ExcessiveOverkill/hvsd-3ch/KiCad/RJ45-Pinout-T568B.jpg

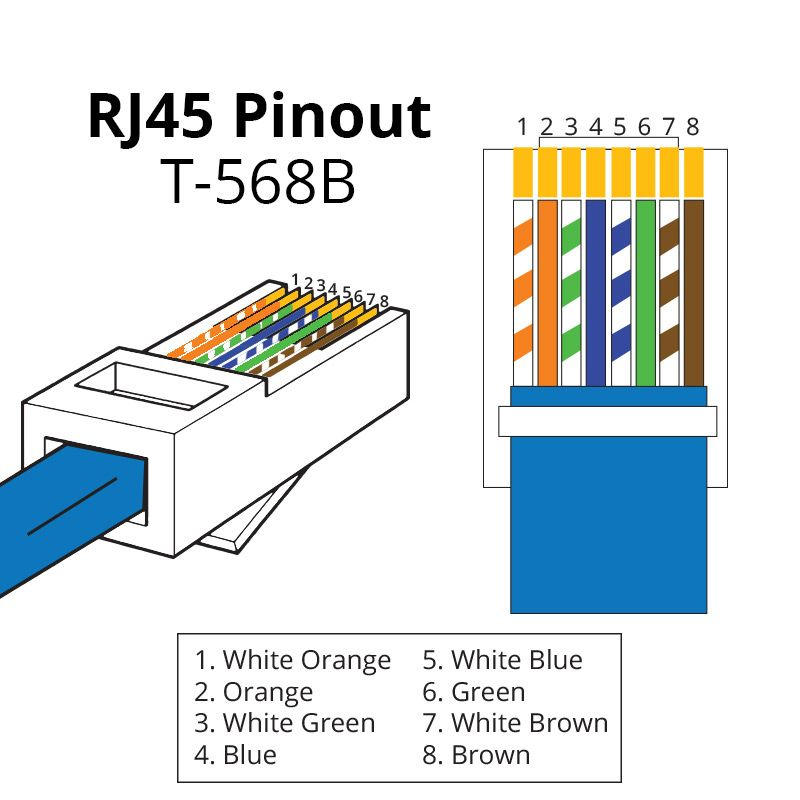
KiCad/RJ45-Pinout-T568B.jpg
