ExcessiveOverkill/hvsd-3ch/KiCad/3d/STM32G473QET6.step

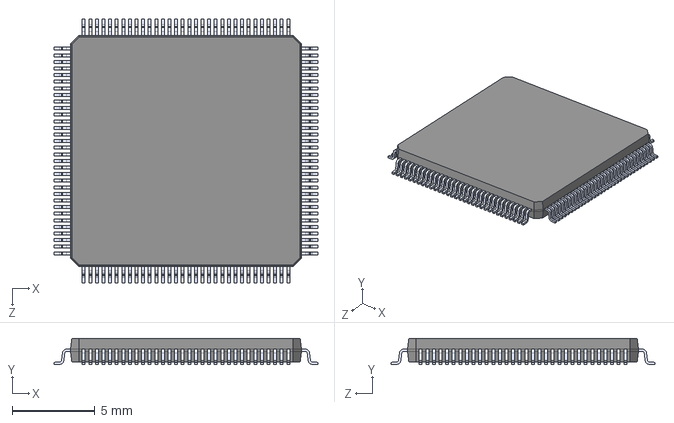
[picture p2: CAD file, 2026-01-03]
KiCad/3d/STM32G473QET6.step
16.0 x 1.60 x 16.0 mm
