ExcessiveOverkill/hvsd-3ch/LTspice/dc vus caps.asc

C1: cap; 220µf; Rser=480m Lser=20nH
C2: cap; 50µf; Rser=4.2m Lser=37.5nH
C3: cap; .3µf
C4: cap; 50µf; Rser=4.2m Lser=37.5nH
C5: cap; 50µf; Rser=4.2m Lser=37.5nH
C6: cap; 1000nf; Lser=15nH
I1: current; PULSE(40 0 0 150ns 150ns 33us 66us 100)
I2: current; PULSE(0 0 22us 150ns 150ns 33us 66us 100)
I3: current; PULSE(0 0 44us 150ns 150ns 33us 66us 100)
L1: ind; 180nH; Rser=.002
L2: ind; 440nH; Rser=.002
V1: voltage; 350; Rser=.1
Named nets: 0
.tran 0 .005 0
