ExcessiveOverkill/hvsd-3ch/KiCad/high voltage servo drive 3ch/high voltage servo drive 3ch.kicad_pcb

## KiCad design KiCad/high voltage servo drive 3ch/high voltage servo drive 3ch.kicad_pcb (2026-08-24)

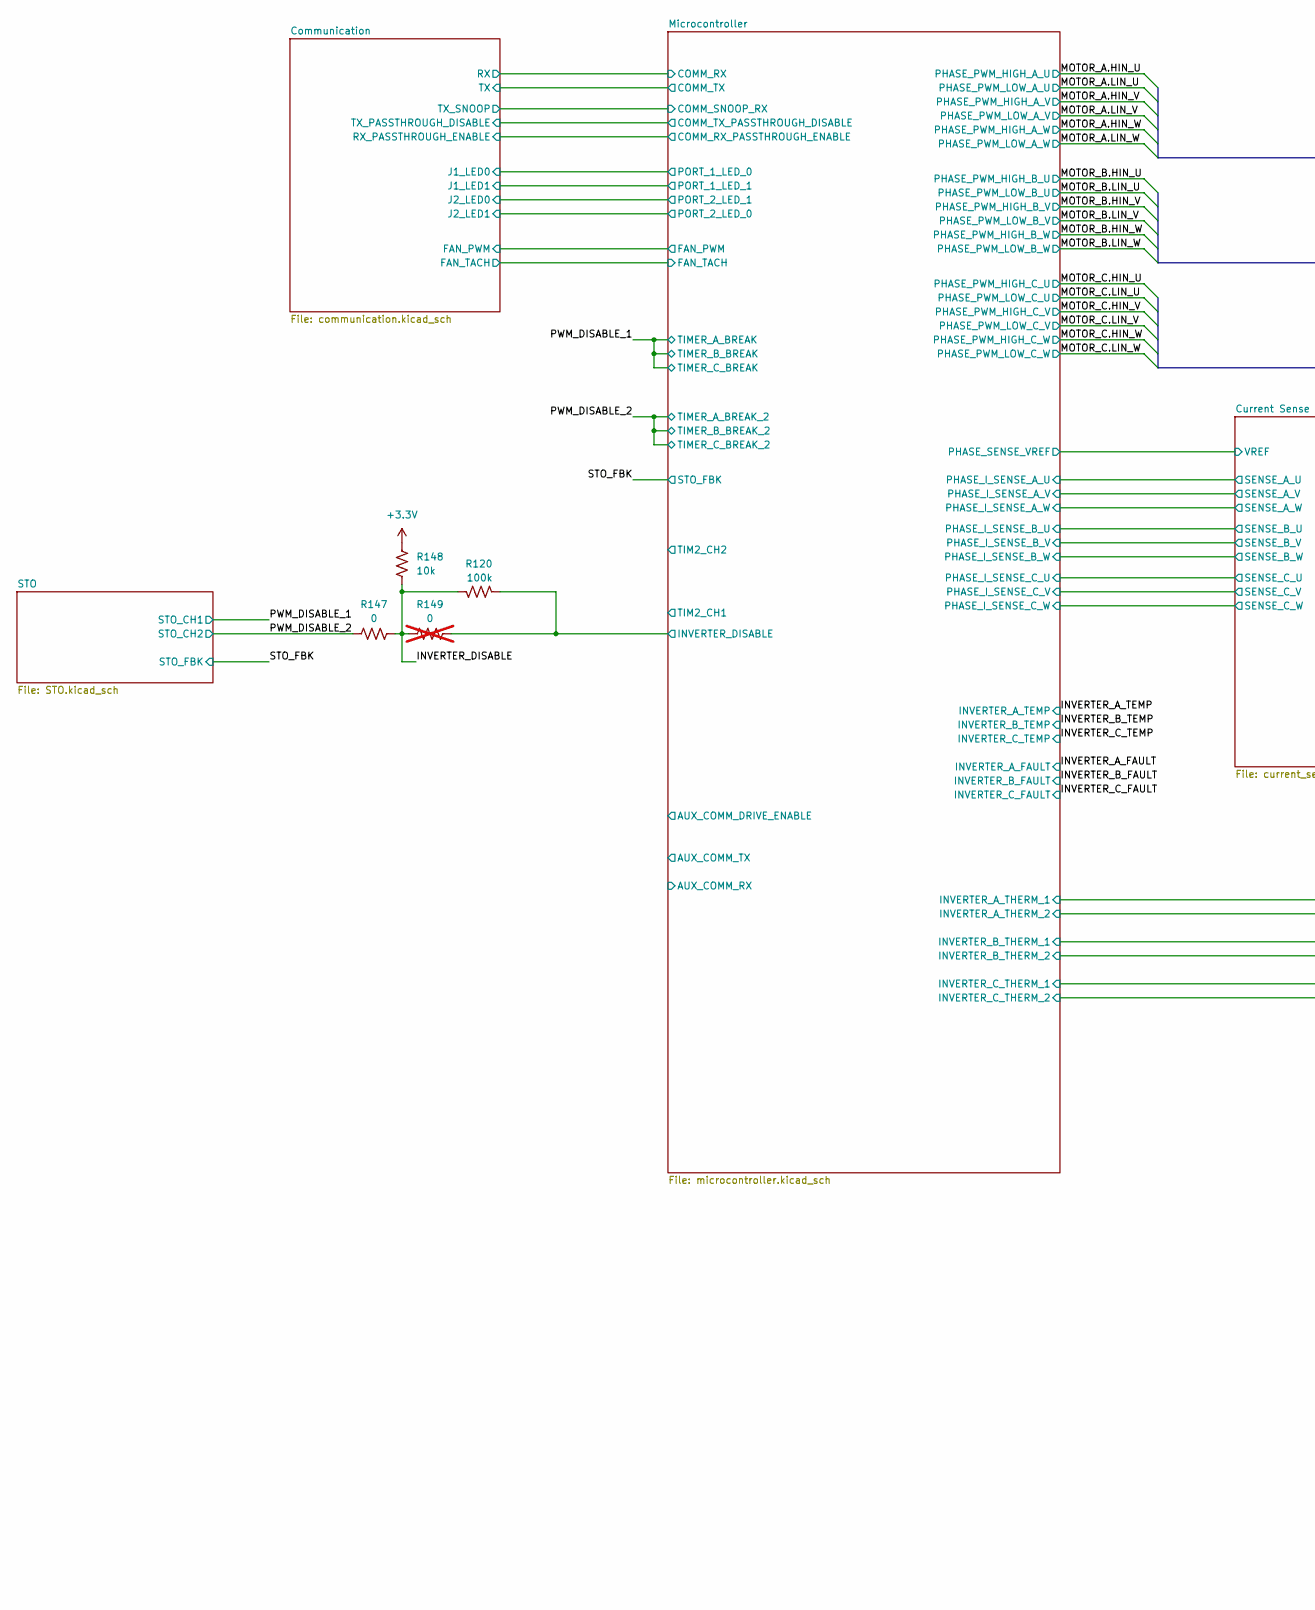
[picture p3: schematic high voltage servo drive 3ch.kicad_sch, part in row 1, column 1]

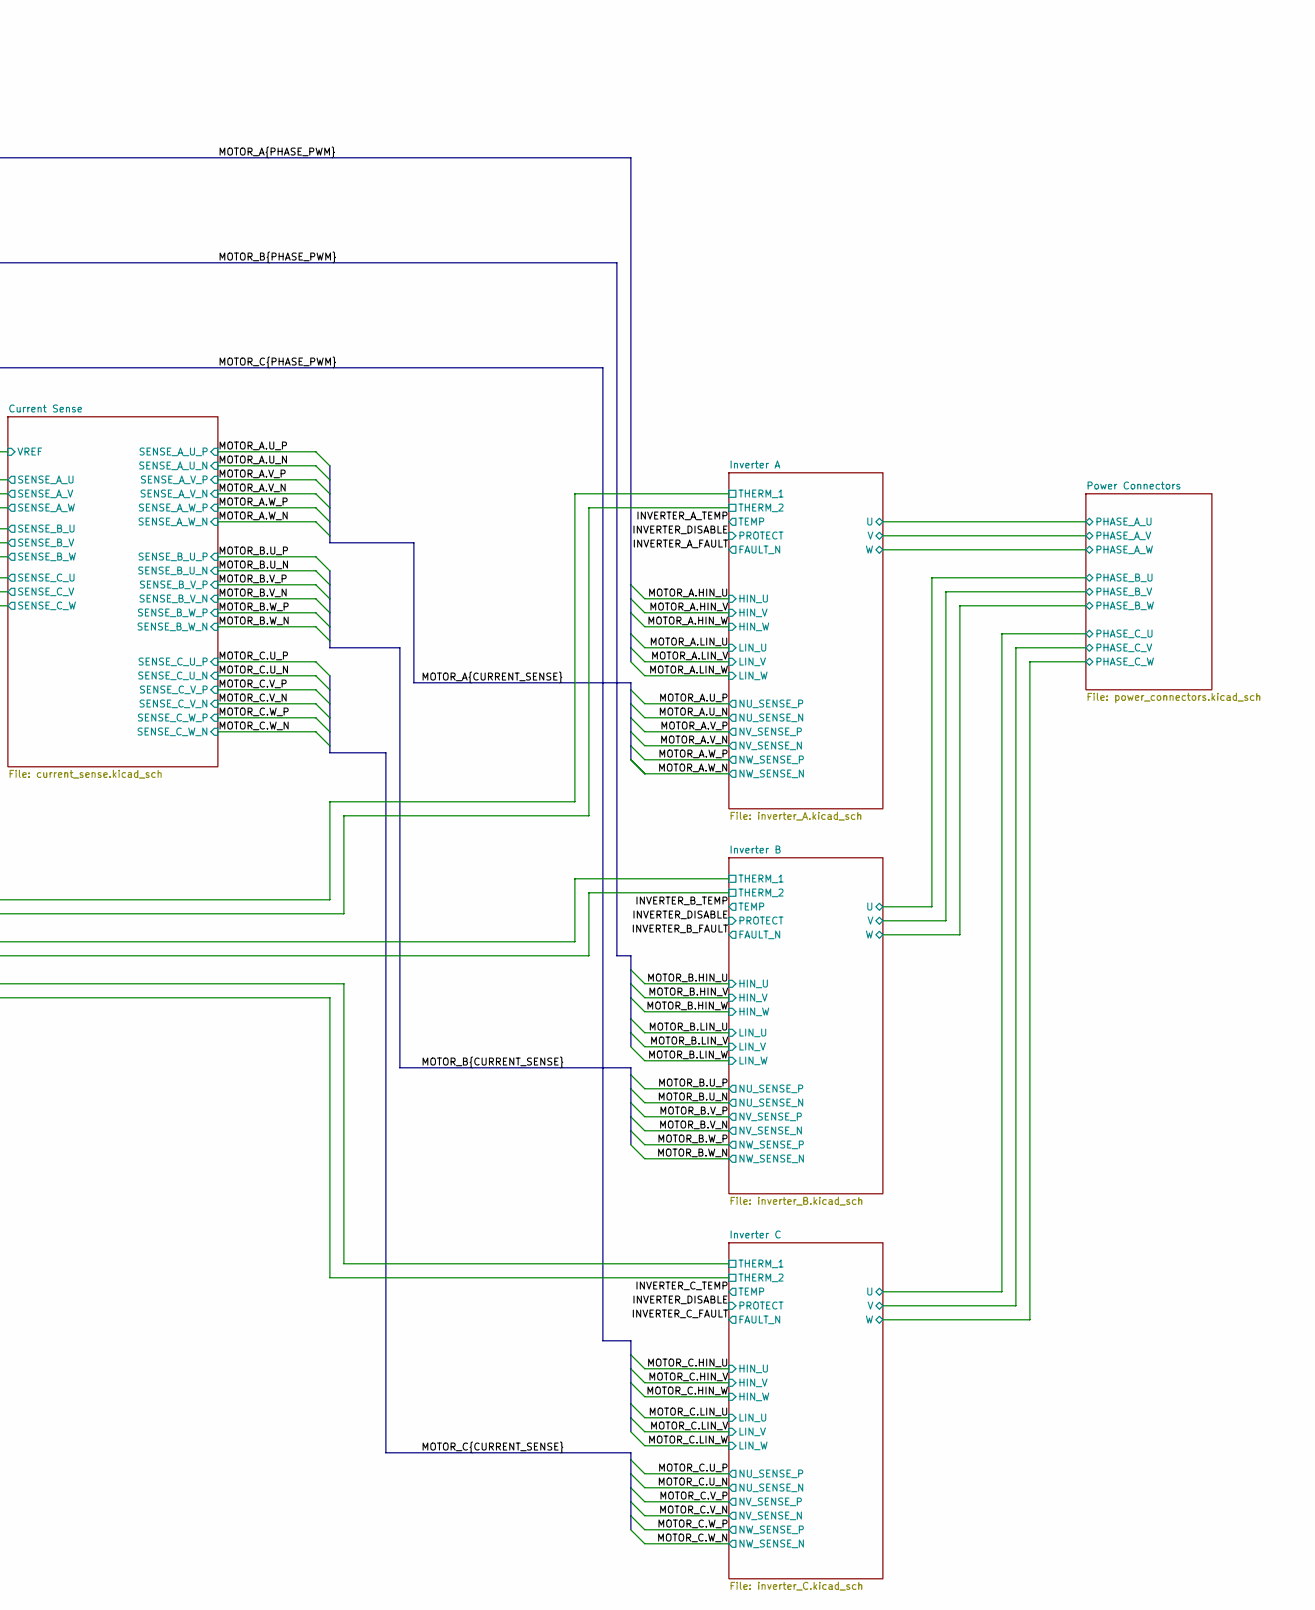
[picture p4: schematic high voltage servo drive 3ch.kicad_sch, part in row 1, column 2]

Parts:
R120: 100k; R_0402_1005Metric; Part number RC0402FR-07100KL; LCSC# C60491
R147: 0; R_0402_1005Metric; Part number RC0402FR-070RL; LCSC# C106231
R148: 10k; R_0402_1005Metric; Part number RC0402FR-0710KL; LCSC# C60490
R149: 0; R_0402_1005Metric; Part number RC0402FR-070RL; LCSC# C106231; not fitted

Connections:
+3.3V: R148.2; also elsewhere on the board
/INVERTER_DISABLE: R120.2, R147.2, R148.1, R149.1; also elsewhere on the board
/Microcontroller/INVERTER_DISABLE: R120.1, R149.2; also elsewhere on the board
/PWM_DISABLE_2: R147.1; also elsewhere on the board

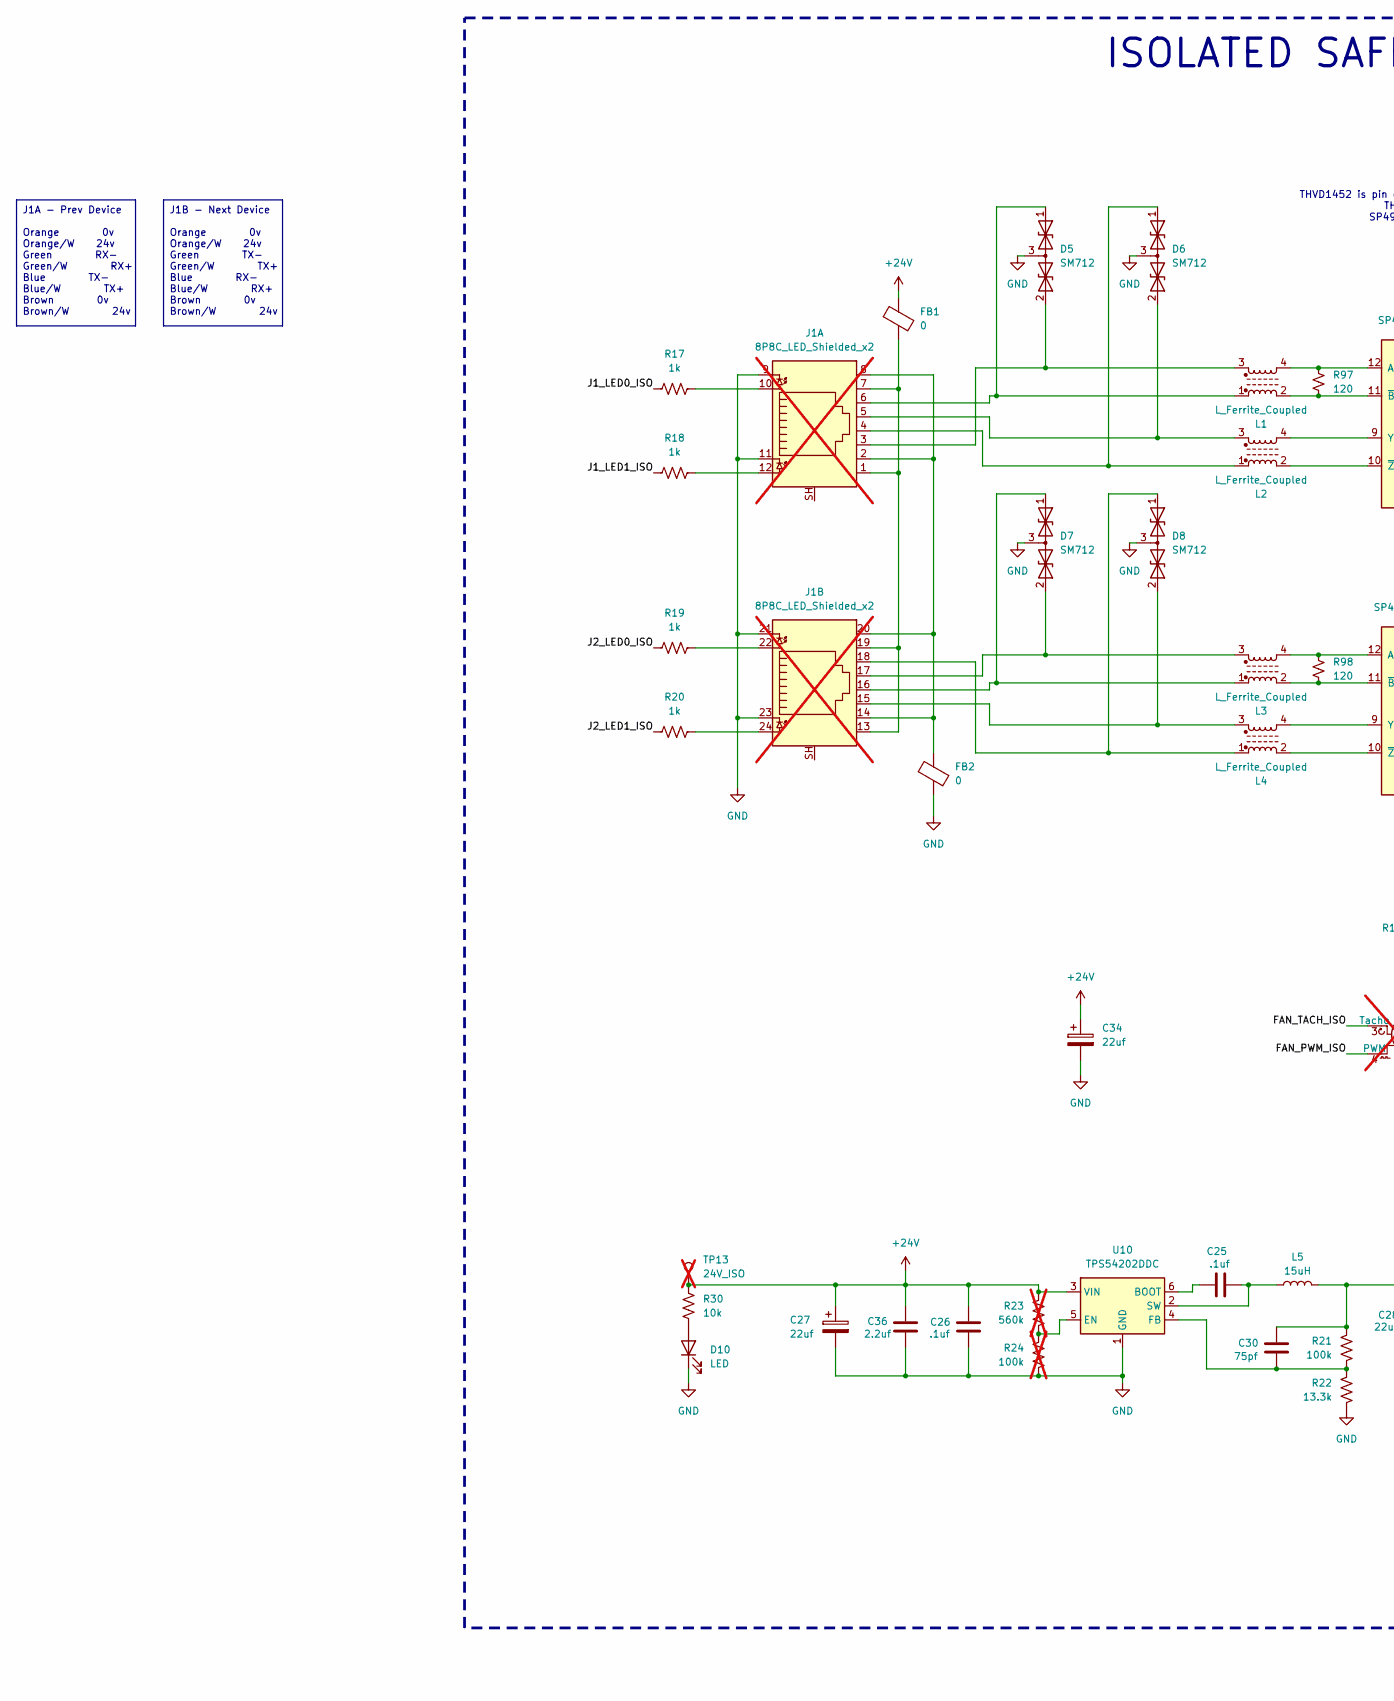
[picture p5: schematic communication.kicad_sch, part in row 1, column 1]

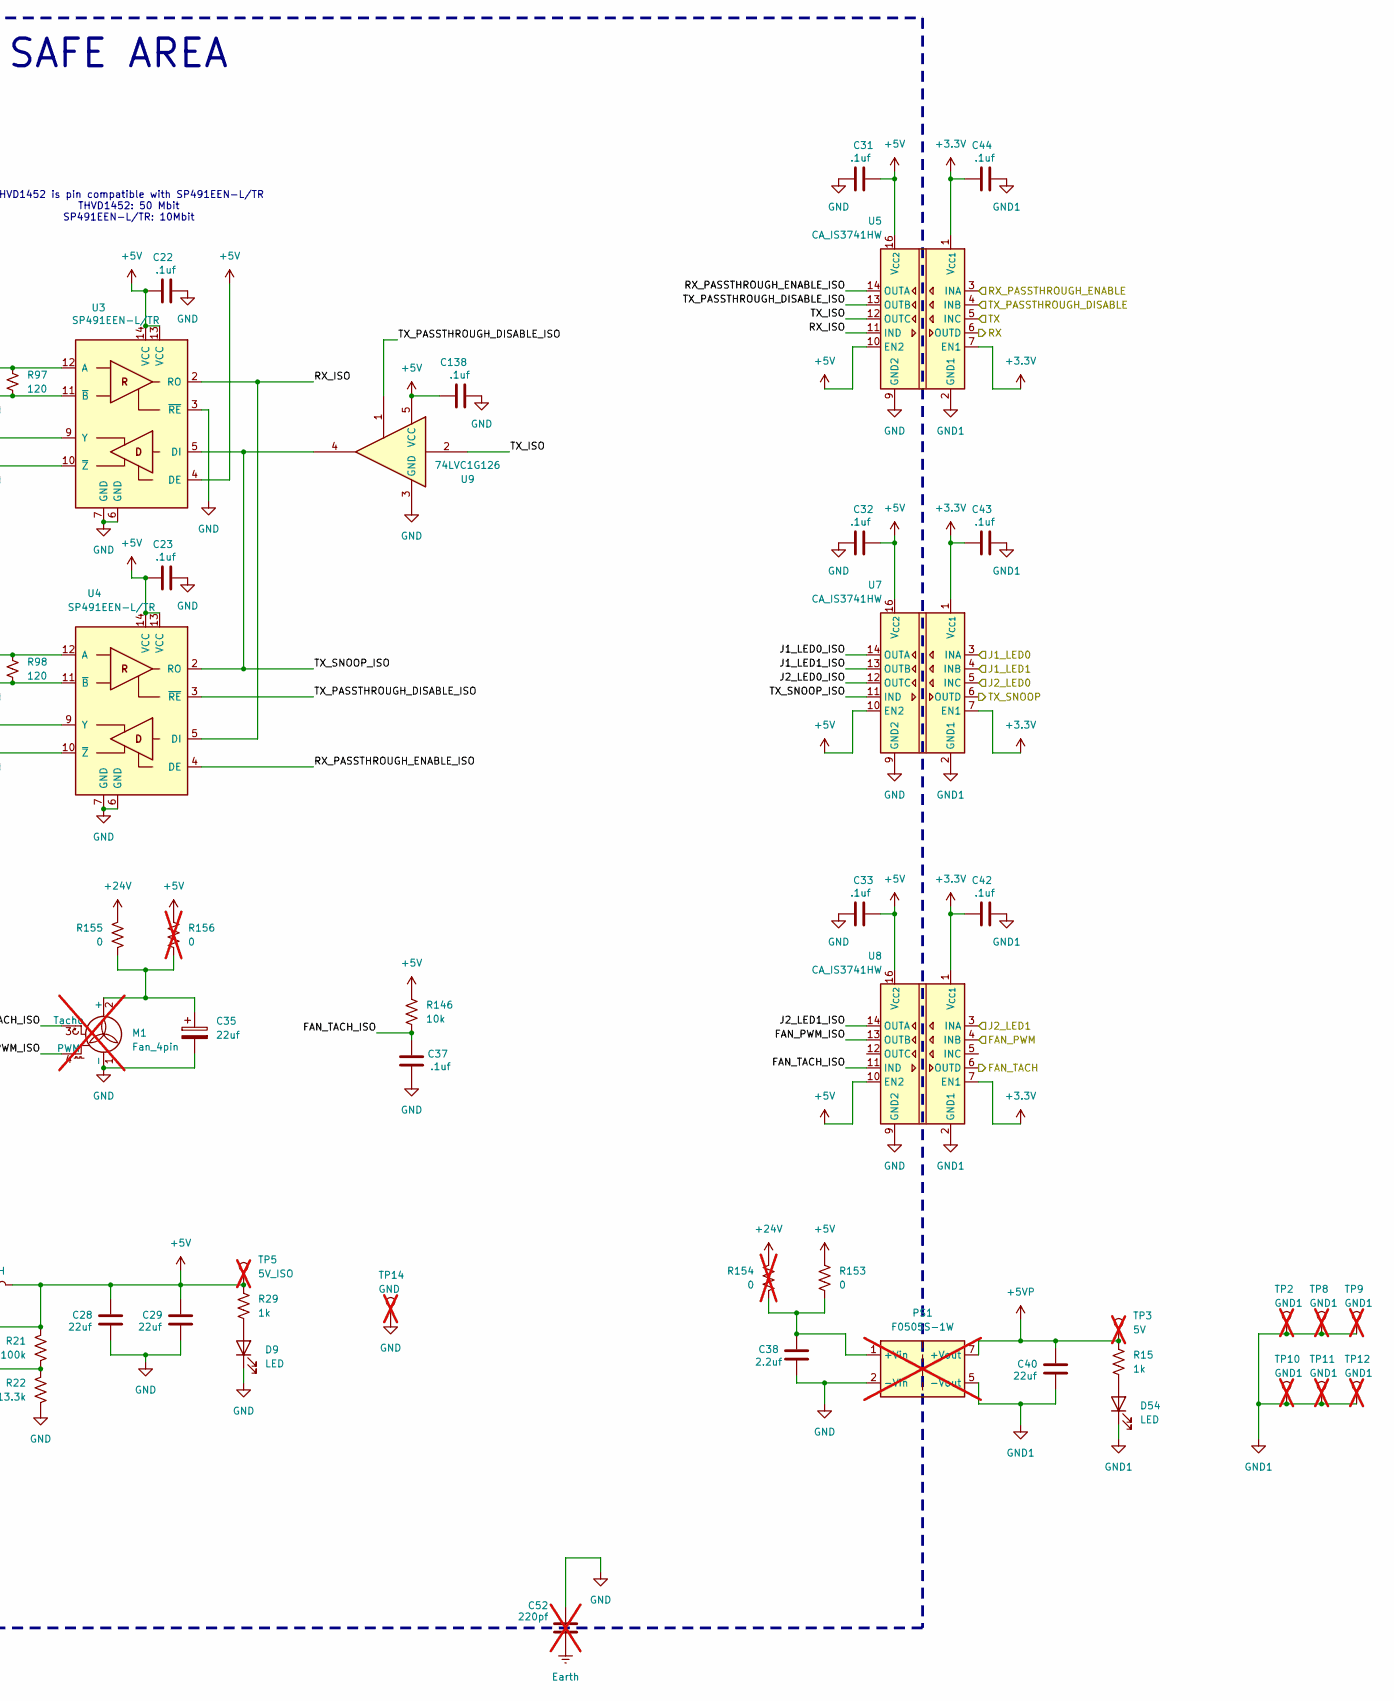
[picture p6: schematic communication.kicad_sch, part in row 1, column 2]

Parts:
C22, C23, C25, C26, C31, C32, C33, C37, C42, C43, C44, C138: .1uf; C_0402_1005Metric; Part number CC0402KRX5R9BB104; LCSC# C105882
C27, C34, C35: 22uf; CP_Elec_6.3x5.9; Part number 189RV0014; LCSC# C7471876
C28, C29, C40: 22uf; C_1206_3216Metric; Part number CL31A226KAHNNNE; LCSC# C12891
C30: 75pf; C_0402_1005Metric; Part number CC0402JRNPO9BN750; LCSC# C107010
C36, C38: 2.2uf; C_1206_3216Metric; Part number CL31B225KBHNNNE; LCSC# C50254
C52: 220pf; C_Disc_D9.0mm_W5.0mm_P10.00mm; not fitted
D5, D6, D7, D8: SM712; SOT-23; Part number CDSOT23-SM712-ES; LCSC# C5199207
D9, D10, D54: LED; LED_0603_1608Metric; Part number XL-1608UGC-04; LCSC# C965804
FB1, FB2: 0; L_0805_2012Metric; Part number FRC0805P000 TS; LCSC# C2907288
J1: 8P8C_LED_Shielded_x2; RJ45_XDRJ-1609-002; Part number XDRJ-1609-002; LCSC# C7498193; not fitted
L1, L2, L3, L4: L_Ferrite_Coupled; SMD-4P,2x1.2mm; Part number CND-WCM0805M801-2; LCSC# C3020807
L5: 15uH; CY54_INDUCTOR; Part number CY54-15UH; LCSC# C2929432
M1: Fan_4pin; PinHeader_1x04_P2.54mm_Vertical; not fitted
PS1: F0505S-1W; Converter_DCDC_FXXS-1W; Part number F0505S-1WR3; LCSC# C2992398; not fitted
R15, R17, R18, R19, R20, R29: 1k; R_0402_1005Metric; Part number RC0402FR-071KL; LCSC# C106235
R21: 100k; R_0402_1005Metric; Part number RC0402FR-07100KL; LCSC# C60491
R22: 13.3k; R_0402_1005Metric; Part number RC0402FR-0713K3L; LCSC# C274352
R23: 560k; R_0402_1005Metric; Part number RC0402FR-07560KL; LCSC# C137958; not fitted
R24: 100k; R_0402_1005Metric; Part number RC0402FR-07100KL; LCSC# C60491; not fitted
R30, R146: 10k; R_0402_1005Metric; Part number RC0402FR-0710KL; LCSC# C60490
R97, R98: 120; R_0402_1005Metric; Part number RC0402FR-07120RL; LCSC# C114758
R153, R155: 0; R_0402_1005Metric; Part number RC0402FR-070RL; LCSC# C106231
R154, R156: 0; R_0402_1005Metric; Part number RC0402FR-070RL; LCSC# C106231; not fitted
TP2, TP8, TP9, TP10, TP11, TP12: GND1; TestPoint_THTPad_D2.0mm_Drill1.0mm; not fitted
TP3: 5V; TestPoint_Pad_D2.0mm; not fitted
TP5: 5V_ISO; TestPoint_Pad_D2.0mm; not fitted
TP13: 24V_ISO; TestPoint_Pad_D2.0mm; not fitted
TP14: GND; TestPoint_THTPad_D2.0mm_Drill1.0mm; not fitted
U3, U4: SP491EEN-L/TR; SOIC-14_3.9x8.7mm_P1.27mm; Part number SP491EEN-L/TR; LCSC# C32476
U5, U7, U8: CA_IS3741HW; SOIC-16W_7.5x10.3mm_P1.27mm; Part number CA-IS3741HW; LCSC# C428890
U9: 74LVC1G126; SOT-353_SC-70-5; Part number 74LVC1G126CT05ARCQ; LCSC# C48391411
U10: TPS54202DDC; SOT-23-6; Part number TPS54202DDCR; LCSC# C191884

Connections:
+3.3V: C42.1, C43.1, C44.1, U5.1 (V_{CC1}), U5.7 (EN1), U7.1 (V_{CC1}), U7.7 (EN1), U8.1 (V_{CC1}), U8.7 (EN1); also elsewhere on the board
+5V: C22.1, C23.1, C28.2, C29.2, C30.2, C31.1, C32.1, C33.1, C138.1, L5.2, R21.2, R29.2, R146.2, R153.2, R156.2, TP5.1, U3.4 (DE), U3.13 (VCC), U3.14 (VCC), U4.13 (VCC), U4.14 (VCC), U5.10 (EN2), U5.16 (V_{CC2}), U7.10 (EN2), U7.16 (V_{CC2}), U8.10 (EN2), U8.16 (V_{CC2}), U9.5 (VCC)
+5VP: C40.2, PS1.7 (+Vout), R15.2, TP3.1; also elsewhere on the board
+24V: C26.2, C27.1, C34.1, C36.2, FB1.1, R23.2, R30.2, R154.2, R155.2, TP13.1, U10.3 (VIN)
/Communication/FAN_PWM: U8.4 (INB); also elsewhere on the board
/Communication/FAN_PWM_ISO: M1.4 (PWM), U8.13 (OUTB)
/Communication/FAN_TACH: U8.6 (OUTD); also elsewhere on the board
/Communication/FAN_TACH_ISO: C37.1, M1.3 (Tacho), R146.1, U8.11 (IND)
/Communication/J1_LED0: U7.3 (INA); also elsewhere on the board
/Communication/J1_LED0_ISO: R17.1, U7.14 (OUTA)
/Communication/J1_LED1: U7.4 (INB); also elsewhere on the board
/Communication/J1_LED1_ISO: R18.1, U7.13 (OUTB)
/Communication/J2_LED0: U7.5 (INC); also elsewhere on the board
/Communication/J2_LED0_ISO: R19.1, U7.12 (OUTC)
/Communication/J2_LED1: U8.3 (INA); also elsewhere on the board
/Communication/J2_LED1_ISO: R20.1, U8.14 (OUTA)
/Communication/RX_ISO: U3.2 (RO), U4.5 (DI), U5.11 (IND)
/Communication/RX_PASSTHROUGH_ENABLE: U5.3 (INA); also elsewhere on the board
/Communication/RX_PASSTHROUGH_ENABLE_ISO: U4.4 (DE), U5.14 (OUTA)
/Communication/TX: U5.5 (INC); also elsewhere on the board
/Communication/TX_ISO: U5.12 (OUTC), U9.2
/Communication/TX_PASSTHROUGH_DISABLE: U5.4 (INB); also elsewhere on the board
/Communication/TX_PASSTHROUGH_DISABLE_ISO: U4.3 (~RE), U5.13 (OUTB), U9.1
/Communication/TX_SNOOP: U7.6 (OUTD); also elsewhere on the board
/Communication/TX_SNOOP_ISO: U3.5 (DI), U4.2 (RO), U7.11 (IND), U9.4
/Microcontroller/COMM_RX: U5.6 (OUTD); also elsewhere on the board
GND: C22.2, C23.2, C26.1, C27.2, C28.1, C29.1, C31.2, C32.2, C33.2, C34.2, C35.2, C36.1, C37.2, C38.1, C52.2, C138.2, D5.3 (common), D6.3 (common), D7.3 (common), D8.3 (common), D9.1 (K), D10.1 (K), FB2.2, J1.9, J1.11, J1.21, J1.23, M1.1 (-), PS1.2 (-Vin), R22.1, R24.1, TP14.1, U3.3 (~RE), U3.6 (GND), U3.7 (GND), U4.6 (GND), U4.7 (GND), U5.9 (GND2), U5.15 (GND2), U7.9 (GND2), U7.15 (GND2), U8.9 (GND2), U8.15 (GND2), U9.3 (GND), U10.1 (GND)
unnamed: D5.1 (A1), J1.6, L1.1
unnamed: D5.2 (A2), J1.3, L1.3
unnamed: D6.1 (A1), J1.4, L2.1
unnamed: D6.2 (A2), J1.5, L2.3
unnamed: D7.1 (A1), J1.16, L3.1
unnamed: D7.2 (A2), J1.17, L3.3
unnamed: D8.1 (A1), J1.18, L4.1
unnamed: D8.2 (A2), J1.15, L4.3
unnamed: D9.2 (A), R29.1
unnamed: D10.2 (A), R30.1
unnamed: D54.2 (A), R15.1
unnamed: FB1.2, J1.1, J1.7, J1.13, J1.19
unnamed: FB2.1, J1.2, J1.8, J1.14, J1.20
unnamed: J1.10, R17.2
unnamed: J1.12, R18.2
unnamed: J1.22, R19.2
unnamed: J1.24, R20.2
unnamed: C35.1, M1.2 (+), R155.1, R156.1
unnamed: C38.2, PS1.1 (+Vin), R153.1, R154.1
unnamed: L1.4, R97.1, U3.12 (A)
unnamed: L2.4, U3.9 (Y)
unnamed: L1.2, R97.2, U3.11 (~B)
unnamed: L2.2, U3.10 (~Z)
unnamed: L3.4, R98.1, U4.12 (A)
unnamed: L4.4, U4.9 (Y)
unnamed: L3.2, R98.2, U4.11 (~B)
unnamed: L4.2, U4.10 (~Z)
unnamed: C25.1, U10.6 (BOOT)
unnamed: R23.1, R24.2, U10.5 (EN)
unnamed: C30.1, R21.1, R22.2, U10.4 (FB)
unnamed: C25.2, L5.1, U10.2 (SW)

Notes on the sheet:
J1B - Next Device Orange 0v Orange/W 24v Green TX- Green/W TX+ Blue RX- Blue/W RX+ Brown 0v Brown/W 24v
J1A - Prev Device Orange 0v Orange/W 24v Green RX- Green/W RX+ Blue TX- Blue/W TX+ Brown 0v Brown/W 24v
THVD1452 is pin compatible with SP491EEN-L/TR THVD1452: 50 Mbit SP491EEN-L/TR: 10Mbit
ISOLATED SAFE AREA

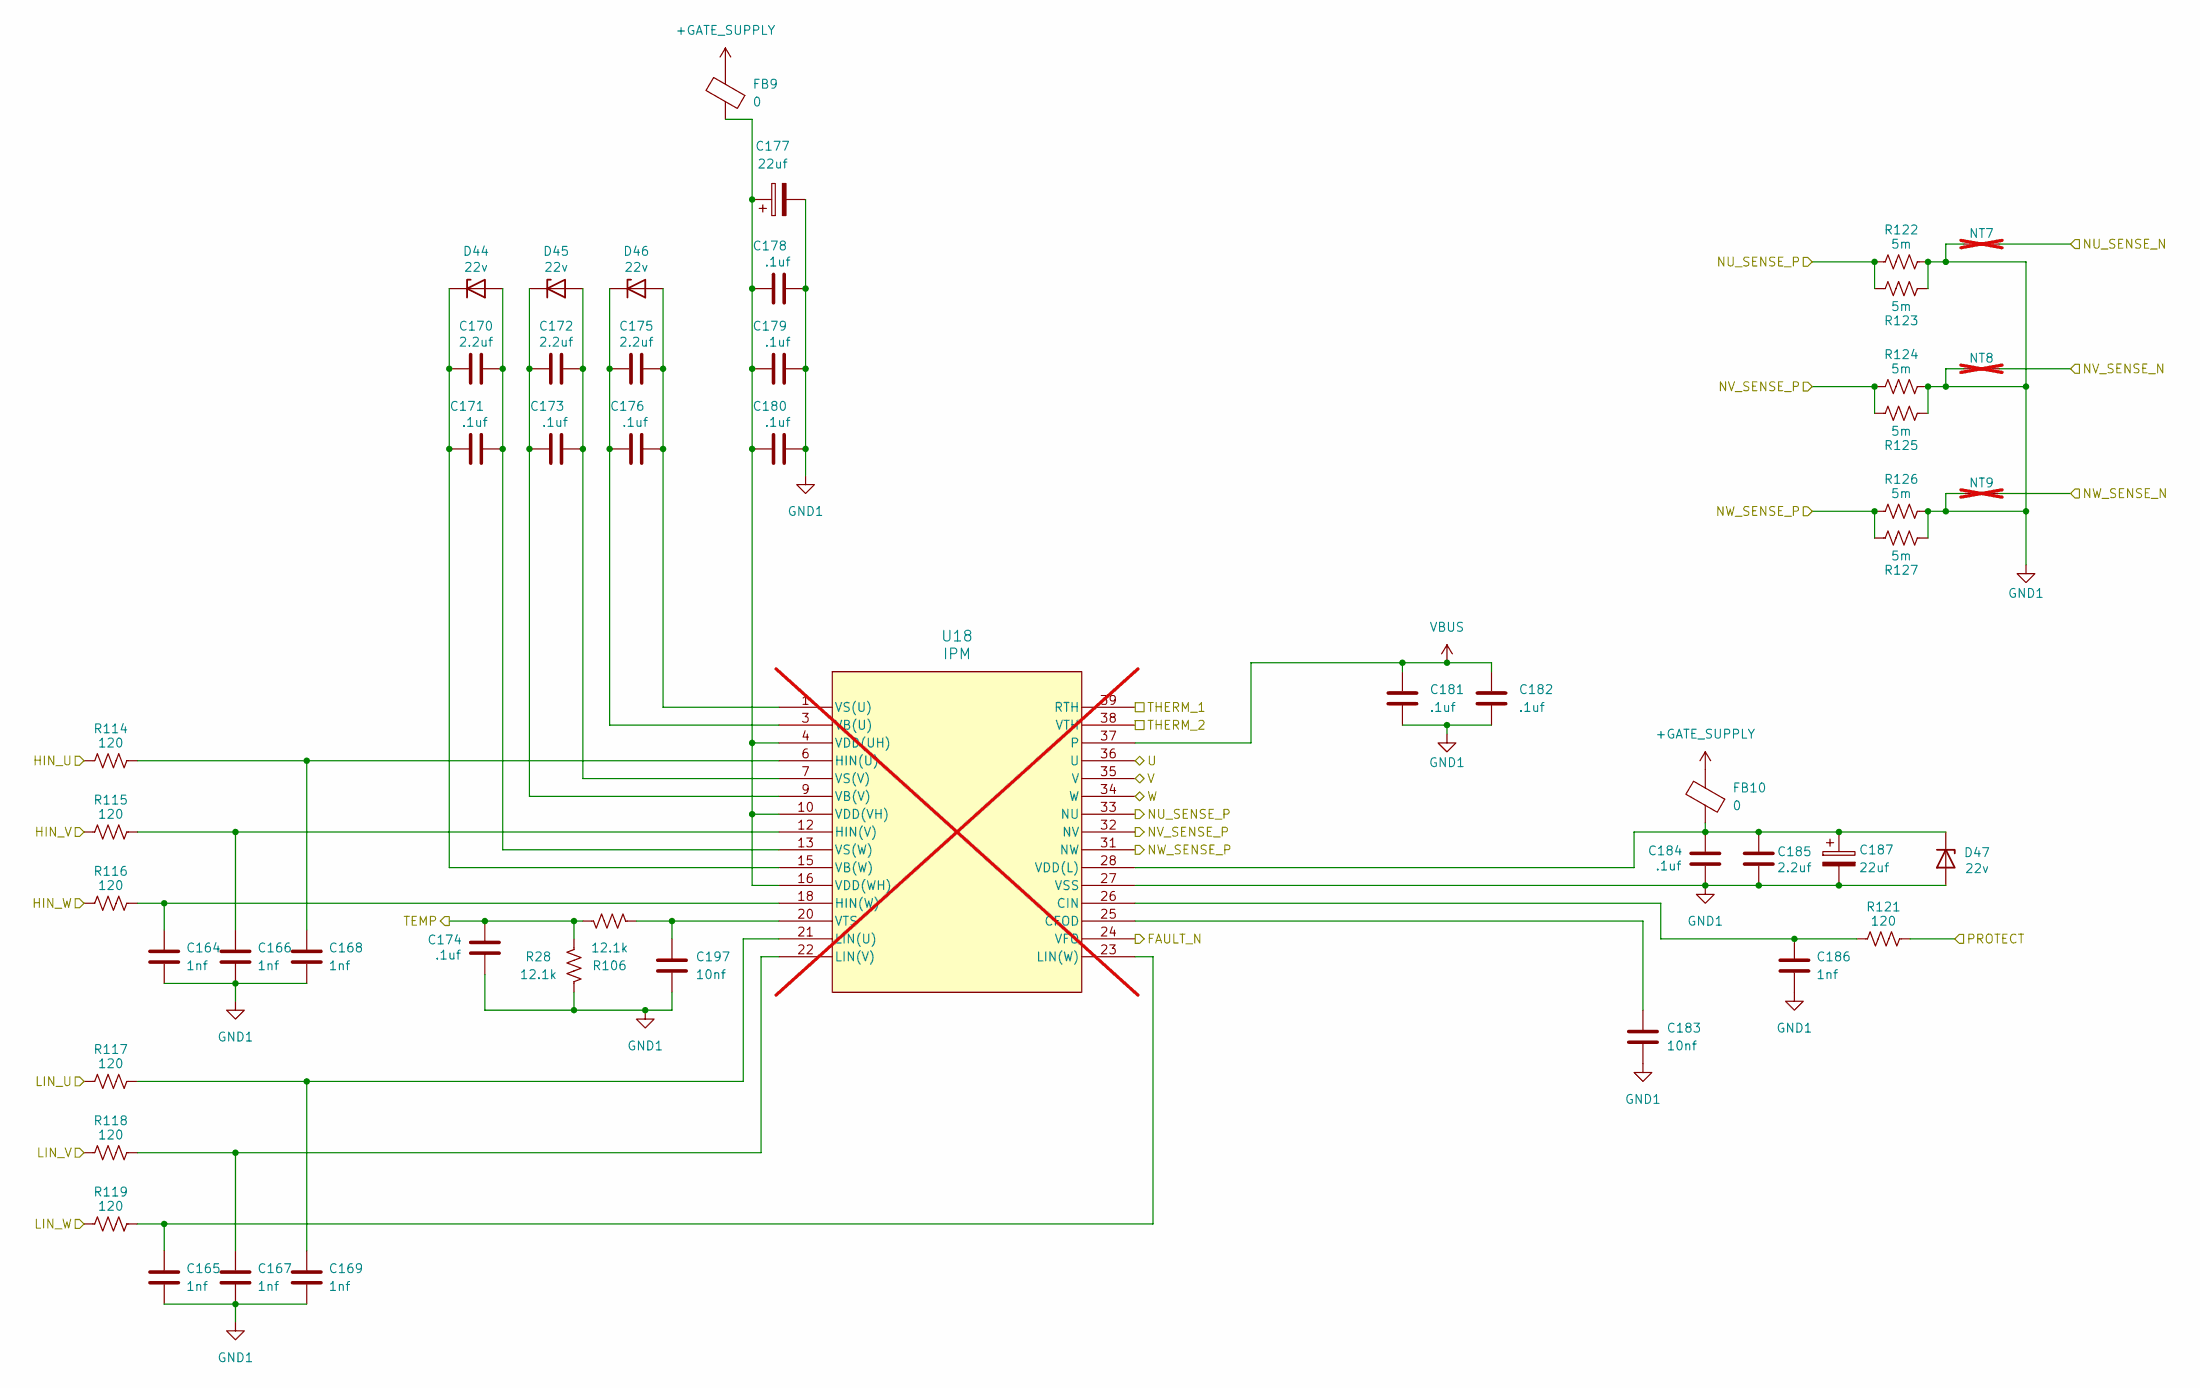
[picture p7: schematic inverter_C.kicad_sch]

Parts:
C164, C165, C166, C167, C168, C169, C186: 1nf; C_0402_1005Metric; Part number CC0402KRX7R9BB102; LCSC# C106205
C170, C172, C175, C185: 2.2uf; C_1206_3216Metric; Part number CL31B225KBHNNNE; LCSC# C50254
C171, C173, C174, C176, C178, C179, C180, C184: .1uf; C_0402_1005Metric; Part number CC0402KRX5R9BB104; LCSC# C105882
C177, C187: 22uf; CP_Elec_6.3x5.9; Part number 189RV0014; LCSC# C7471876
C181, C182: .1uf; C_1812_4532Metric; Part number NV1812B104K102CEMN; LCSC# C780707
C183, C197: 10nf; C_0402_1005Metric; Part number CC0402KRX7R9BB103; LCSC# C60133
D44, D45, D46, D47: 22v; D_SMA; Part number SMA2Z22A; LCSC# C7440711
FB9, FB10: 0; L_0805_2012Metric; Part number FRC0805P000 TS; LCSC# C2907288
NT7, NT8, NT9: NetTie_2; NetTie-2_SMD_Pad0.2mm; not fitted
R28, R106: 12.1k; R_0402_1005Metric; Part number RC0402FR-0712K1L; LCSC# C132157
R114, R115, R116, R117, R118, R119, R121: 120; R_0402_1005Metric; Part number RC0402FR-07120RL; LCSC# C114758
R122, R123, R124, R125, R126, R127: 5m; R_1206_3216Metric; Part number FRM121WFR005TM; LCSC# C7419996
U18: IPM; DIP39_54.5X31.0_MODGC_OSI; not fitted

Connections:
+GATE_SUPPLY: FB9.2, FB10.2; also elsewhere on the board
/INVERTER_C_FAULT: U18.24 (VFO); also elsewhere on the board
/INVERTER_C_TEMP: C174.2, R28.1, R106.1; also elsewhere on the board
/INVERTER_DISABLE: R121.2; also elsewhere on the board
/Inverter C/THERM_1: U18.39 (RTH); also elsewhere on the board
/Inverter C/U: U18.36 (U); also elsewhere on the board
/Inverter C/V: U18.35 (V); also elsewhere on the board
/Inverter C/W: U18.34 (W); also elsewhere on the board
/MOTOR_C.HIN_U: R114.1; also elsewhere on the board
/MOTOR_C.HIN_V: R115.1; also elsewhere on the board
/MOTOR_C.HIN_W: R116.1; also elsewhere on the board
/MOTOR_C.LIN_U: R117.1; also elsewhere on the board
/MOTOR_C.LIN_V: R118.1; also elsewhere on the board
/MOTOR_C.LIN_W: R119.1; also elsewhere on the board
/MOTOR_C.U_N: NT7.2; also elsewhere on the board
/MOTOR_C.U_P: R122.1, R123.2, U18.33 (NU); also elsewhere on the board
/MOTOR_C.V_N: NT8.2; also elsewhere on the board
/MOTOR_C.V_P: R124.1, R125.2, U18.32 (NV); also elsewhere on the board
/MOTOR_C.W_N: NT9.2; also elsewhere on the board
/MOTOR_C.W_P: R126.1, R127.2, U18.31 (NW); also elsewhere on the board
/Microcontroller/INVERTER_C_THERM: U18.38 (VTH); also elsewhere on the board
unnamed: C170.2, C171.2, D44.2 (A), U18.13 (VS(W))
unnamed: C170.1, C171.1, D44.1 (K), U18.15 (VB(W))
unnamed: C172.2, C173.2, D45.2 (A), U18.7 (VS(V))
unnamed: C172.1, C173.1, D45.1 (K), U18.9 (VB(V))
unnamed: C175.2, C176.2, D46.2 (A), U18.1 (VS(U))
unnamed: C175.1, C176.1, D46.1 (K), U18.3 (VB(U))
unnamed: C184.2, C185.1, C187.1, D47.1 (K), FB10.1, U18.28 (VDD(L))
unnamed: C183.1, U18.25 (CFOD)
unnamed: C186.1, R121.1, U18.26 (CIN)
unnamed: C168.1, R114.2, U18.6 (HIN(U))
unnamed: C166.1, R115.2, U18.12 (HIN(V))
unnamed: C164.1, R116.2, U18.18 (HIN(W))
unnamed: C169.1, R117.2, U18.21 (LIN(U))
unnamed: C167.1, R118.2, U18.22 (LIN(V))
unnamed: C165.1, R119.2, U18.23 (LIN(W))
unnamed: C177.1, C178.1, C179.1, C180.1, FB9.1, U18.4 (VDD(UH)), U18.10 (VDD(VH)), U18.16 (VDD(WH))
unnamed: C197.1, R106.2, U18.20 (VTS)
VBUS: C181.1, C182.1, U18.37; also elsewhere on the board

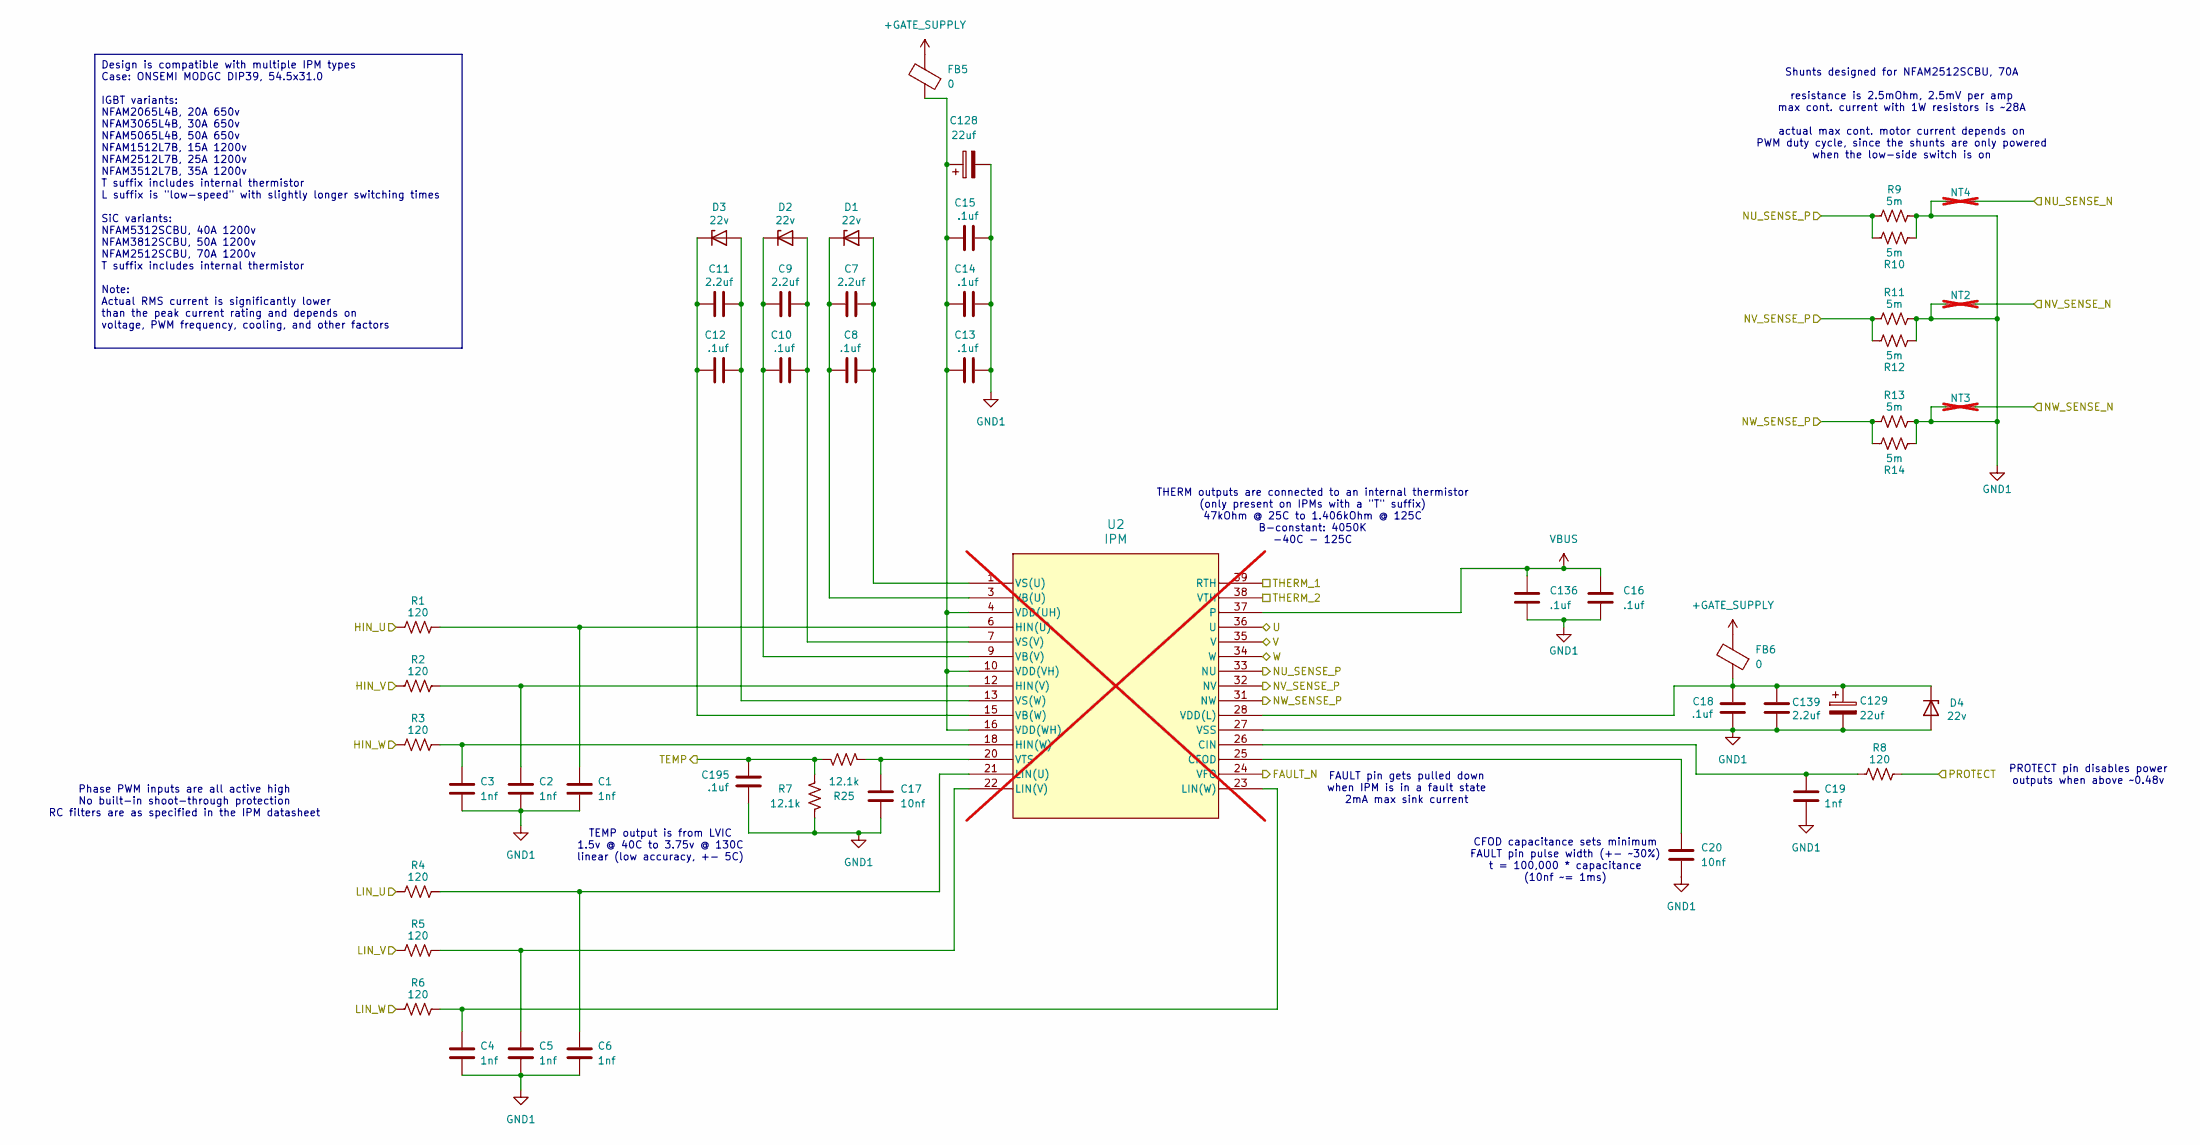
[picture p8: schematic inverter_A.kicad_sch]

Parts:
C1, C2, C3, C4, C5, C6, C19: 1nf; C_0402_1005Metric; Part number CC0402KRX7R9BB102; LCSC# C106205
C7, C9, C11, C139: 2.2uf; C_1206_3216Metric; Part number CL31B225KBHNNNE; LCSC# C50254
C8, C10, C12, C13, C14, C15, C18, C195: .1uf; C_0402_1005Metric; Part number CC0402KRX5R9BB104; LCSC# C105882
C16, C136: .1uf; C_1812_4532Metric; Part number NV1812B104K102CEMN; LCSC# C780707
C17, C20: 10nf; C_0402_1005Metric; Part number CC0402KRX7R9BB103; LCSC# C60133
C128, C129: 22uf; CP_Elec_6.3x5.9; Part number 189RV0014; LCSC# C7471876
D1, D2, D3, D4: 22v; D_SMA; Part number SMA2Z22A; LCSC# C7440711
FB5, FB6: 0; L_0805_2012Metric; Part number FRC0805P000 TS; LCSC# C2907288
NT2, NT3, NT4: NetTie_2; NetTie-2_SMD_Pad0.2mm; not fitted
R1, R2, R3, R4, R5, R6, R8: 120; R_0402_1005Metric; Part number RC0402FR-07120RL; LCSC# C114758
R7, R25: 12.1k; R_0402_1005Metric; Part number RC0402FR-0712K1L; LCSC# C132157
R9, R10, R11, R12, R13, R14: 5m; R_1206_3216Metric; Part number FRM121WFR005TM; LCSC# C7419996
U2: IPM; DIP39_54.5X31.0_MODGC_OSI; not fitted

Connections:
+GATE_SUPPLY: FB5.2, FB6.2; also elsewhere on the board
/INVERTER_A_FAULT: U2.24 (VFO); also elsewhere on the board
/INVERTER_A_TEMP: C195.2, R7.1, R25.1; also elsewhere on the board
/INVERTER_DISABLE: R8.2; also elsewhere on the board
/Inverter A/THERM_1: U2.39 (RTH); also elsewhere on the board
/Inverter A/U: U2.36 (U); also elsewhere on the board
/Inverter A/V: U2.35 (V); also elsewhere on the board
/Inverter A/W: U2.34 (W); also elsewhere on the board
/MOTOR_A.HIN_U: R1.1; also elsewhere on the board
/MOTOR_A.HIN_V: R2.1; also elsewhere on the board
/MOTOR_A.HIN_W: R3.1; also elsewhere on the board
/MOTOR_A.LIN_U: R4.1; also elsewhere on the board
/MOTOR_A.LIN_V: R5.1; also elsewhere on the board
/MOTOR_A.LIN_W: R6.1; also elsewhere on the board
/MOTOR_A.U_N: NT4.2; also elsewhere on the board
/MOTOR_A.U_P: R9.1, R10.2, U2.33 (NU); also elsewhere on the board
/MOTOR_A.V_N: NT2.2; also elsewhere on the board
/MOTOR_A.V_P: R11.1, R12.2, U2.32 (NV); also elsewhere on the board
/MOTOR_A.W_N: NT3.2; also elsewhere on the board
/MOTOR_A.W_P: R13.1, R14.2, U2.31 (NW); also elsewhere on the board
/Microcontroller/INVERTER_A_THERM: U2.38 (VTH); also elsewhere on the board
unnamed: C7.2, C8.2, D1.2 (A), U2.1 (VS(U))
unnamed: C7.1, C8.1, D1.1 (K), U2.3 (VB(U))
unnamed: C9.2, C10.2, D2.2 (A), U2.7 (VS(V))
unnamed: C9.1, C10.1, D2.1 (K), U2.9 (VB(V))
unnamed: C11.2, C12.2, D3.2 (A), U2.13 (VS(W))
unnamed: C11.1, C12.1, D3.1 (K), U2.15 (VB(W))
unnamed: C18.2, C129.1, C139.1, D4.1 (K), FB6.1, U2.28 (VDD(L))
unnamed: C20.1, U2.25 (CFOD)
unnamed: C19.1, R8.1, U2.26 (CIN)
unnamed: C1.1, R1.2, U2.6 (HIN(U))
unnamed: C2.1, R2.2, U2.12 (HIN(V))
unnamed: C3.1, R3.2, U2.18 (HIN(W))
unnamed: C6.1, R4.2, U2.21 (LIN(U))
unnamed: C5.1, R5.2, U2.22 (LIN(V))
unnamed: C4.1, R6.2, U2.23 (LIN(W))
unnamed: C13.1, C14.1, C15.1, C128.1, FB5.1, U2.4 (VDD(UH)), U2.10 (VDD(VH)), U2.16 (VDD(WH))
unnamed: C17.1, R25.2, U2.20 (VTS)
VBUS: C16.1, C136.1, U2.37; also elsewhere on the board

Notes on the sheet:
Design is compatible with multiple IPM types Case: ONSEMI MODGC DIP39, 54.5x31.0 IGBT variants: NFAM2065L4B, 20A 650v NFAM3065L4B, 30A 650v NFAM5065L4B, 50A 650v NFAM1512L7B, 15A 1200v NFAM2512L7B, 25A 1200v NFAM3512L7B, 35A 1200v T suffix includes internal thermistor L suffix is "low-speed" with s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
TEMP output is from LVIC 1.5v @ 40C to 3.75v @ 130C linear (low accuracy, +- 5C)
CFOD capacitance sets minimum FAULT pin pulse width (+- ~30%) t = 100,000 * capacitance (10nf ~= 1ms)
Shunts designed for NFAM2512SCBU, 70A resistance is 2.5mOhm, 2.5mV per amp max cont. current with 1W resistors is ~28A actual max cont. motor current depends on PWM duty cycle, since the shunts are only powered when the low-side switch is on
THERM outputs are connected to an internal thermistor (only present on IPMs with a "T" suffix) 47kOhm @ 25C to 1.406kOhm @ 125C B-constant: 4050K -40C - 125C
FAULT pin gets pulled down when IPM is in a fault state 2mA max sink current
PROTECT pin disables power outputs when above ~0.48v
Phase PWM inputs are all active high No built-in shoot-through protection RC filters are as specified in the IPM datasheet
