ExcessiveOverkill/hvsd-3ch/KiCad/high voltage servo drive 3ch/high voltage servo drive 3ch.kicad_pcb

## KiCad design KiCad/high voltage servo drive 3ch/high voltage servo drive 3ch.kicad_pcb (continued)

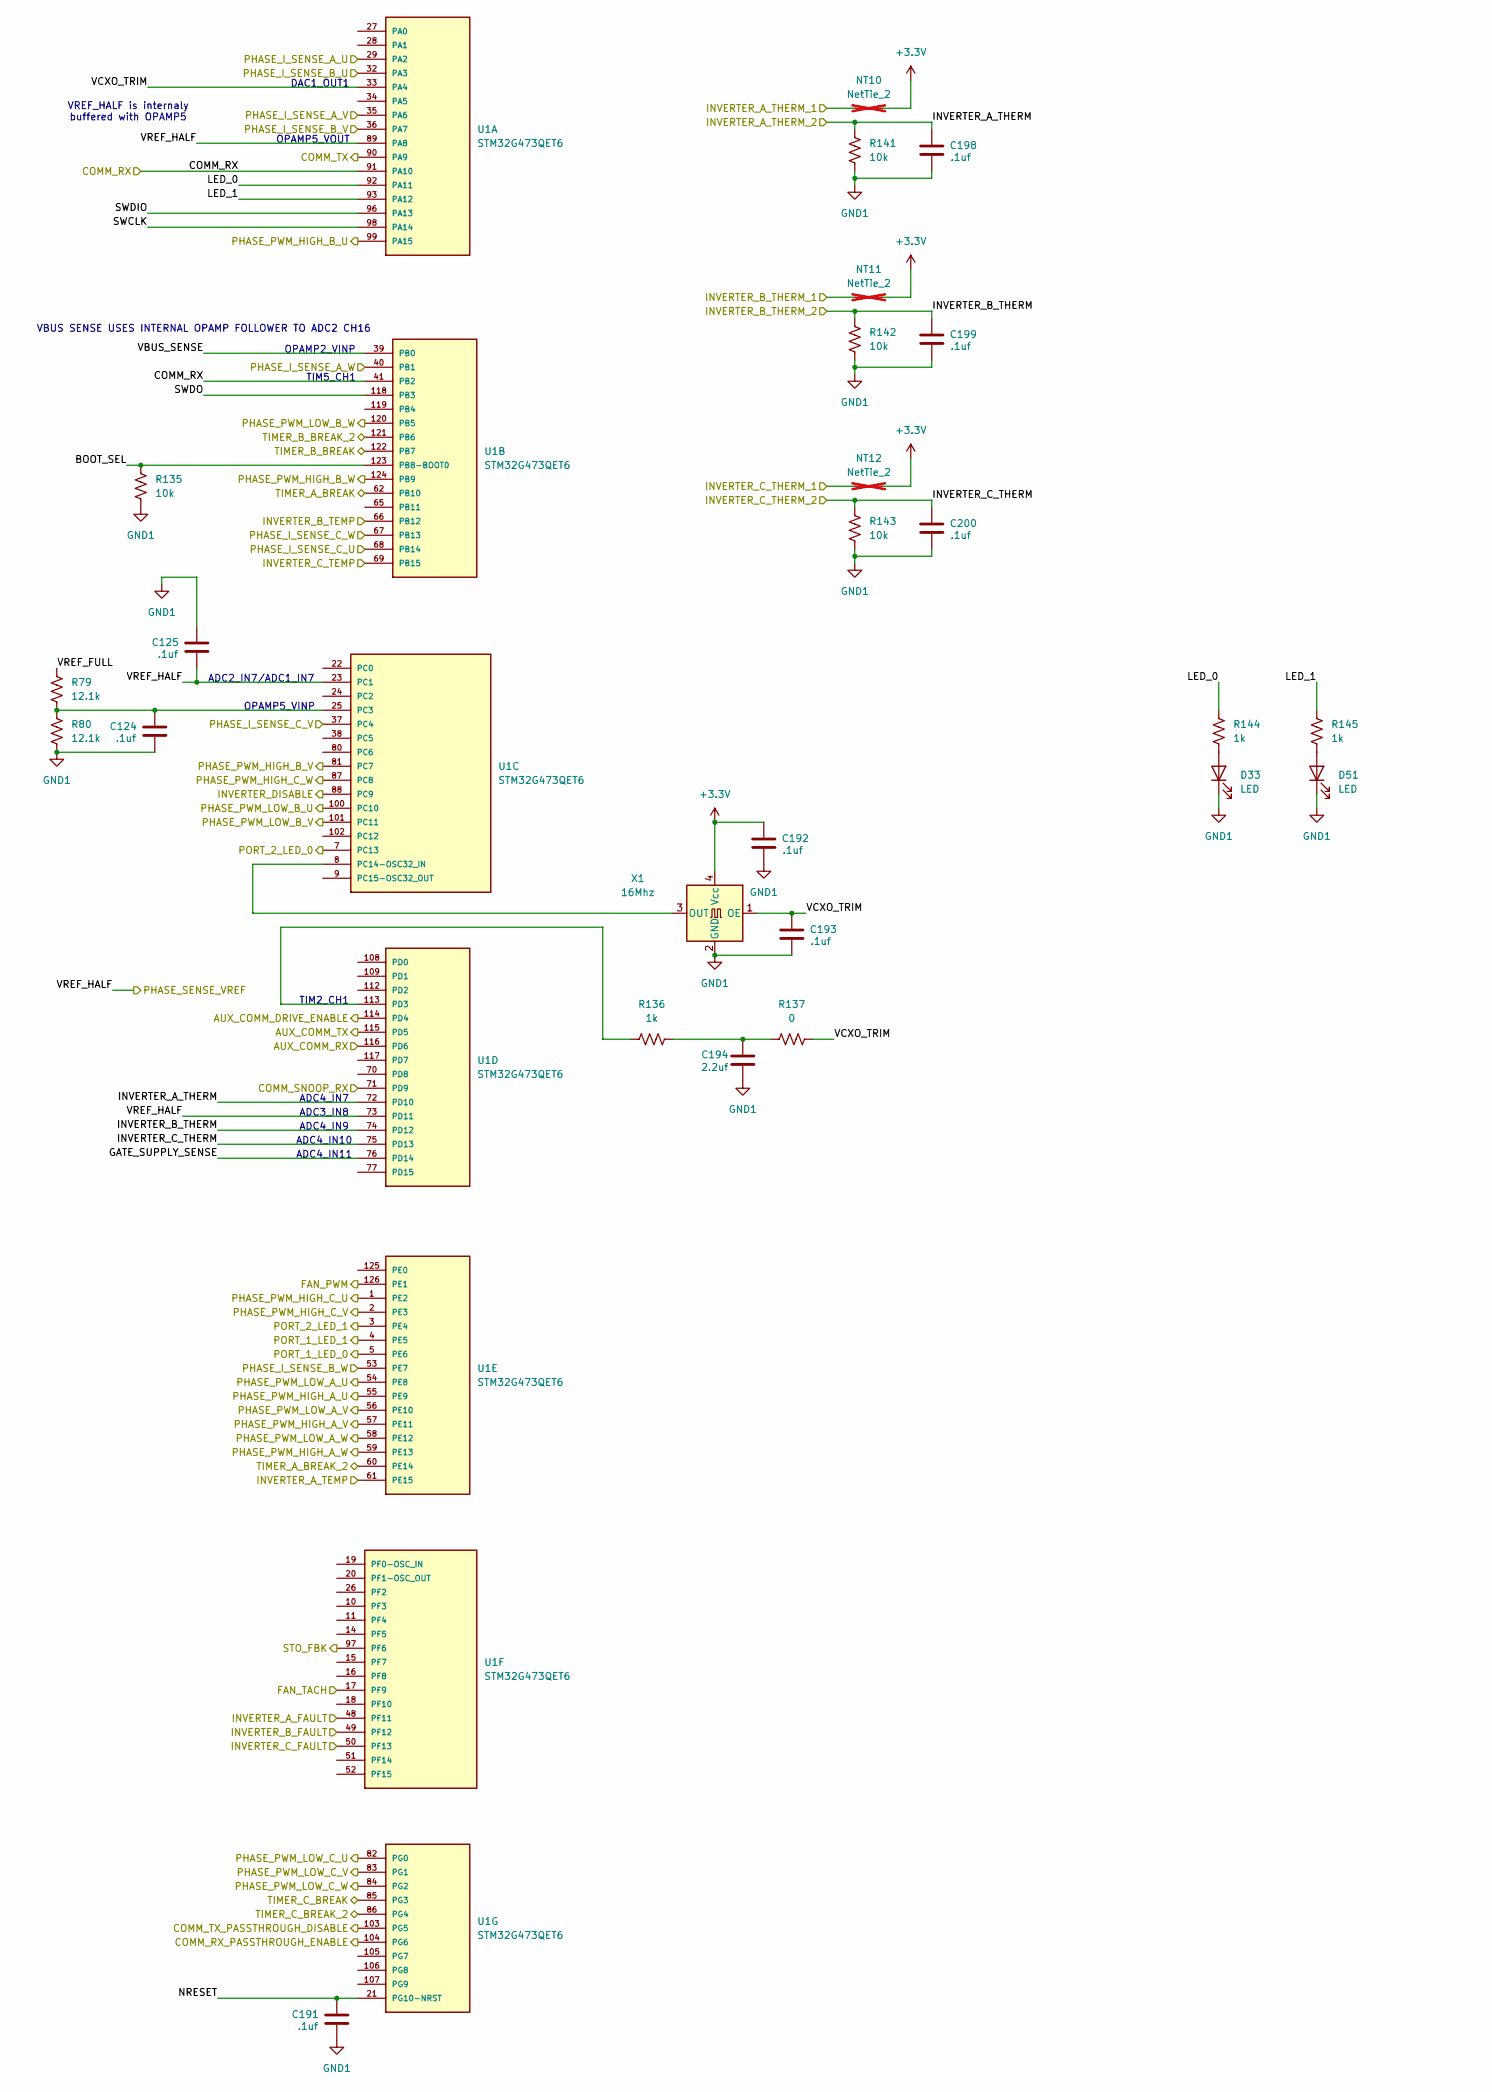
[picture p9: schematic microcontroller.kicad_sch, part in row 1, column 1]

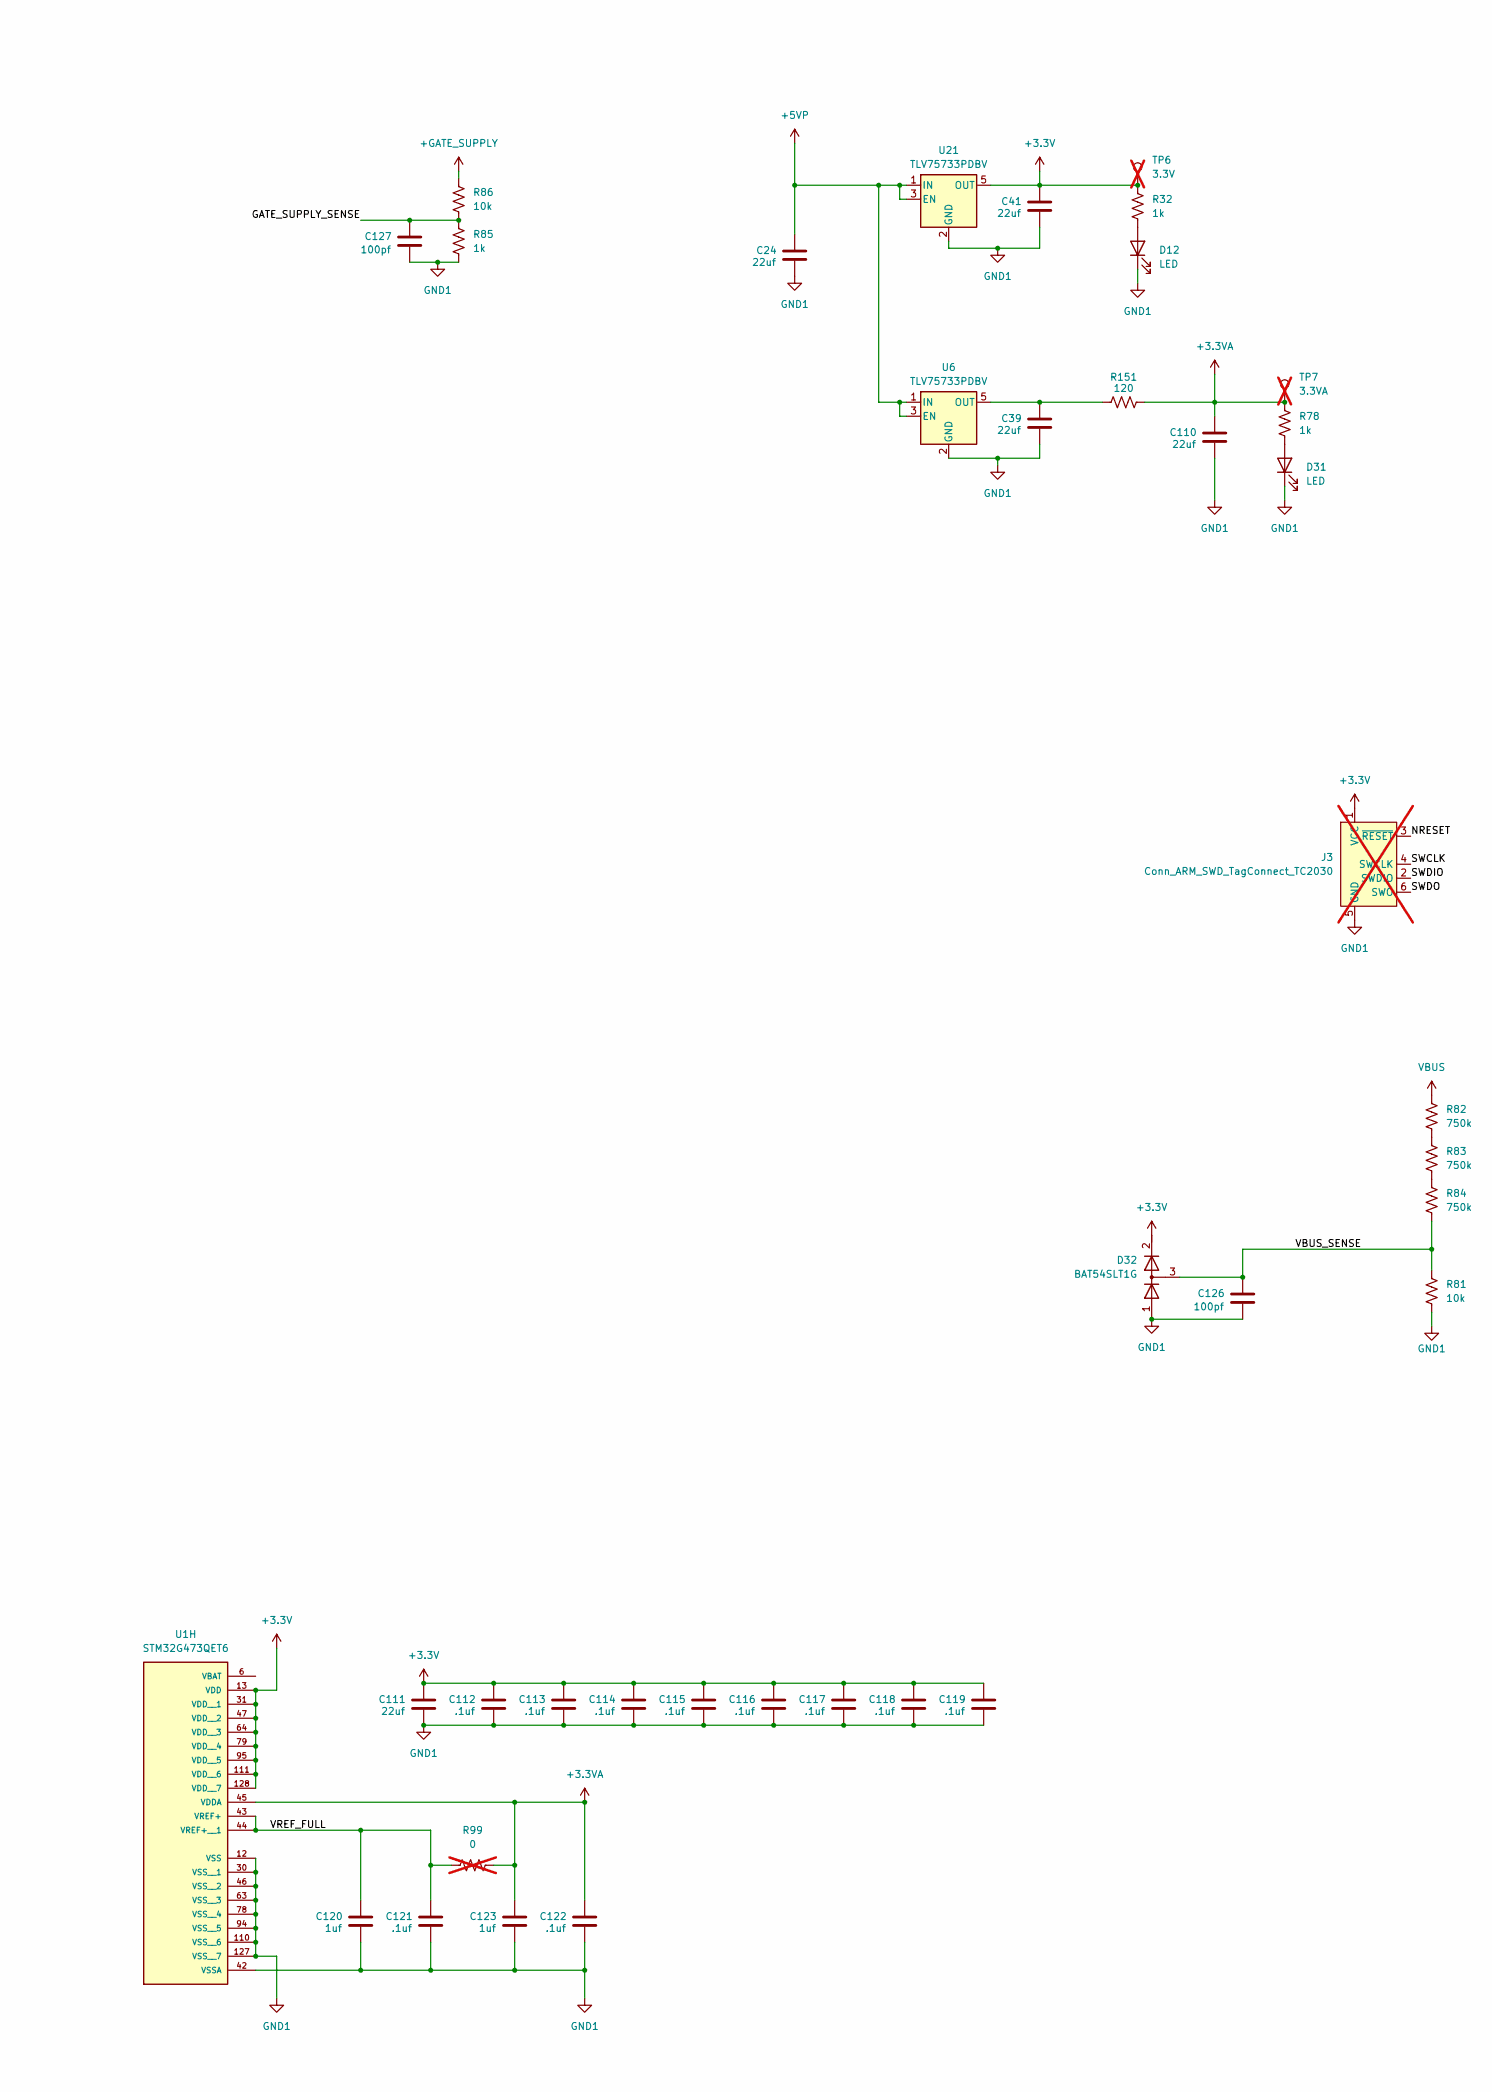
[picture p10: schematic microcontroller.kicad_sch, part in row 1, column 2]

Parts:
C24, C39, C41, C110, C111: 22uf; C_1206_3216Metric; Part number CL31A226KAHNNNE; LCSC# C12891
C112, C113, C114, C115, C116, C117, C118, C119, C121, C122, C124, C125, C191, C192, C193, C198, C199, C200: .1uf; C_0402_1005Metric; Part number CC0402KRX5R9BB104; LCSC# C105882
C120, C123: 1uf; C_0402_1005Metric; Part number CL05A105KP5NNNC; LCSC# C14445
C126, C127: 100pf; C_0402_1005Metric; Part number CC0402JRNPO9BN101; LCSC# C106200
C194: 2.2uf; C_1206_3216Metric; Part number CL31B225KBHNNNE; LCSC# C50254
D12, D31, D33, D51: LED; LED_0603_1608Metric; Part number XL-1608UBC-04; LCSC# C965807
D32: BAT54SLT1G; SOT-23; Part number LBAT54SLT1G; LCSC# C12765
J3: Conn_ARM_SWD_TagConnect_TC2030; Tag-Connect_TC2030-IDC-FP_2x03_P1.27mm_Vertical; not fitted
NT10, NT11, NT12: NetTie_2; NetTie-2_SMD_Pad0.2mm; not fitted
R32, R78, R85, R136, R144, R145: 1k; R_0402_1005Metric; Part number RC0402FR-071KL; LCSC# C106235
R79, R80: 12.1k; R_0402_1005Metric; Part number RC0402FR-0712K1L; LCSC# C132157
R81, R86, R135, R141, R142, R143: 10k; R_0402_1005Metric; Part number RC0402FR-0710KL; LCSC# C60490
R82, R83, R84: 750k; R_1206_3216Metric; Part number RC1206FR-07750KL; LCSC# C137235
R99: 0; R_0402_1005Metric; Part number RC0402FR-070RL; LCSC# C106231; not fitted
R137: 0; R_0402_1005Metric; Part number RC0402FR-070RL; LCSC# C106231
R151: 120; R_0402_1005Metric; Part number RC0402FR-07120RL; LCSC# C114758
TP6: 3.3V; TestPoint_Pad_D2.0mm; not fitted
TP7: 3.3VA; TestPoint_Pad_D2.0mm; not fitted
U1: STM32G473QET6; QFP40P1600X1600X160-128N; PARTREV 4
U6, U21: TLV75733PDBV; SOT-23-5; Part number TLV75733PDBVR; LCSC# C485517
X1: 16Mhz; Oscillator_SMD_SeikoEpson_SG8002CE-4Pin_3.2x2.5mm; Part number SG-8002CE 16.000000MHz PHM; LCSC# C390318

Connections:
+3.3V: C41.2, C111.2, C112.2, C113.2, C114.2, C115.2, C116.2, C117.2, C118.2, C119.2, C192.2, D32.2 (K), J3.1 (VCC), NT10.2, NT11.2, NT12.2, R32.2, TP6.1, U1.13 (VDD), U1.31 (VDD__1), U1.47 (VDD__2), U1.64 (VDD__3), U1.79 (VDD__4), U1.95 (VDD__5), U1.111 (VDD__6), U1.128 (VDD__7), U21.5 (OUT), X1.4 (Vcc); also elsewhere on the board
+3.3VA: C110.2, C122.2, C123.2, R78.2, R99.2, R151.2, TP7.1, U1.45 (VDDA); also elsewhere on the board
+5VP: C24.2, U6.1 (IN), U6.3 (EN), U21.1 (IN), U21.3 (EN); also elsewhere on the board
+GATE_SUPPLY: R86.2; also elsewhere on the board
/Communication/FAN_PWM: U1.126 (PE1); also elsewhere on the board
/Communication/FAN_TACH: U1.17 (PF9); also elsewhere on the board
/Communication/J1_LED0: U1.5 (PE6); also elsewhere on the board
/Communication/J1_LED1: U1.4 (PE5); also elsewhere on the board
/Communication/J2_LED0: U1.3 (PE4); also elsewhere on the board
/Communication/J2_LED1: U1.7 (PC13); also elsewhere on the board
/Communication/RX_PASSTHROUGH_ENABLE: U1.104 (PG6); also elsewhere on the board
/Communication/TX: U1.90 (PA9); also elsewhere on the board
/Communication/TX_PASSTHROUGH_DISABLE: U1.103 (PG5); also elsewhere on the board
/Communication/TX_SNOOP: U1.71 (PD9); also elsewhere on the board
/Current Sense/SENSE_A_U: U1.29 (PA2); also elsewhere on the board
/Current Sense/SENSE_A_V: U1.35 (PA6); also elsewhere on the board
/Current Sense/SENSE_A_W: U1.40 (PB1); also elsewhere on the board
/Current Sense/SENSE_B_U: U1.32 (PA3); also elsewhere on the board
/Current Sense/SENSE_B_V: U1.36 (PA7); also elsewhere on the board
/Current Sense/SENSE_B_W: U1.53 (PE7); also elsewhere on the board
/Current Sense/SENSE_C_U: U1.68 (PB14); also elsewhere on the board
/Current Sense/SENSE_C_V: U1.37 (PC4); also elsewhere on the board
/Current Sense/SENSE_C_W: U1.67 (PB13); also elsewhere on the board
/INVERTER_A_FAULT: U1.48 (PF11); also elsewhere on the board
/INVERTER_A_TEMP: U1.61 (PE15); also elsewhere on the board
/INVERTER_B_FAULT: U1.49 (PF12); also elsewhere on the board
/INVERTER_B_TEMP: U1.66 (PB12); also elsewhere on the board
/INVERTER_C_FAULT: U1.50 (PF13); also elsewhere on the board
/INVERTER_C_TEMP: U1.69 (PB15); also elsewhere on the board
/Inverter A/THERM_1: NT10.1; also elsewhere on the board
/Inverter B/THERM_1: NT11.1; also elsewhere on the board
/Inverter C/THERM_1: NT12.1; also elsewhere on the board
/MOTOR_A.HIN_U: U1.55 (PE9); also elsewhere on the board
/MOTOR_A.HIN_V: U1.57 (PE11); also elsewhere on the board
/MOTOR_A.HIN_W: U1.59 (PE13); also elsewhere on the board
/MOTOR_A.LIN_U: U1.54 (PE8); also elsewhere on the board
/MOTOR_A.LIN_V: U1.56 (PE10); also elsewhere on the board
/MOTOR_A.LIN_W: U1.58 (PE12); also elsewhere on the board
/MOTOR_B.HIN_U: U1.99 (PA15); also elsewhere on the board
/MOTOR_B.HIN_V: U1.81 (PC7); also elsewhere on the board
/MOTOR_B.HIN_W: U1.124 (PB9); also elsewhere on the board
/MOTOR_B.LIN_U: U1.100 (PC10); also elsewhere on the board
/MOTOR_B.LIN_V: U1.101 (PC11); also elsewhere on the board
/MOTOR_B.LIN_W: U1.120 (PB5); also elsewhere on the board
/MOTOR_C.HIN_U: U1.1 (PE2); also elsewhere on the board
/MOTOR_C.HIN_V: U1.2 (PE3); also elsewhere on the board
/MOTOR_C.HIN_W: U1.87 (PC8); also elsewhere on the board
/MOTOR_C.LIN_U: U1.82 (PG0); also elsewhere on the board
/MOTOR_C.LIN_V: U1.83 (PG1); also elsewhere on the board
/MOTOR_C.LIN_W: U1.84 (PG2); also elsewhere on the board
/Microcontroller/AUX_COMM_DRIVE_ENABLE: U1.114 (PD4)
/Microcontroller/AUX_COMM_RX: U1.116 (PD6)
/Microcontroller/AUX_COMM_TX: U1.115 (PD5)
/Microcontroller/BOOT_SEL: R135.2, U1.123 (PB8-BOOT0)
/Microcontroller/COMM_RX: U1.41 (PB2), U1.91 (PA10); also elsewhere on the board
/Microcontroller/GATE_SUPPLY_SENSE: C127.2, R85.2, R86.1, U1.76 (PD14)
/Microcontroller/INVERTER_A_THERM: C198.2, R141.1, U1.72 (PD10); also elsewhere on the board
/Microcontroller/INVERTER_B_THERM: C199.2, R142.1, U1.74 (PD12); also elsewhere on the board
/Microcontroller/INVERTER_C_THERM: C200.2, R143.1, U1.75 (PD13); also elsewhere on the board
/Microcontroller/INVERTER_DISABLE: U1.88 (PC9); also elsewhere on the board
/Microcontroller/LED_0: R144.2, U1.92 (PA11)
/Microcontroller/LED_1: R145.2, U1.93 (PA12)
/Microcontroller/NRESET: C191.2, J3.3 (~RESET), U1.21 (PG10-NRST)
/Microcontroller/SWCLK: J3.4 (SWCLK), U1.98 (PA14)
/Microcontroller/SWDIO: J3.2 (SWDIO), U1.96 (PA13)
/Microcontroller/SWDO: J3.6 (SWO), U1.118 (PB3)
/Microcontroller/VCXO_TRIM: C193.2, R137.1, U1.33 (PA4), X1.1 (OE)
/Microcontroller/VREF_FULL: C120.2, C121.2, R79.1, R99.1, U1.43 (VREF+), U1.44 (VREF+__1)
/Microcontroller/VREF_HALF: C125.1, U1.23 (PC1), U1.73 (PD11), U1.89 (PA8); also elsewhere on the board
/PWM_DISABLE_1: U1.62 (PB10), U1.85 (PG3), U1.122 (PB7); also elsewhere on the board
/PWM_DISABLE_2: U1.60 (PE14), U1.86 (PG4), U1.121 (PB6); also elsewhere on the board
/STO_FBK: U1.97 (PF6); also elsewhere on the board
unnamed: C194.2, R136.1, R137.2
unnamed: D12.2 (A), R32.1
unnamed: D31.2 (A), R78.1
unnamed: D33.2 (A), R144.1
unnamed: D51.2 (A), R145.1
unnamed: R82.2, R83.1
unnamed: R83.2, R84.1
unnamed: C124.2, R79.2, R80.1, U1.25 (PC3)
unnamed: R136.2, U1.113 (PD3)
unnamed 235: C39.2, R151.1, U6.5 (OUT); also elsewhere on the board
VBUS: R82.1; also elsewhere on the board

Notes on the sheet:
ADC3_IN8
VREF_HALF is internaly buffered with OPAMP5
ADC4_IN9
ADC2_IN7/ADC1_IN7
VBUS SENSE USES INTERNAL OPAMP FOLLOWER TO ADC2 CH16
ADC4_IN7
TIM5_CH1
ADC4_IN11
OPAMP2_VINP
OPAMP5_VOUT
ADC4_IN10
OPAMP5_VINP
TIM2_CH1
DAC1_OUT1

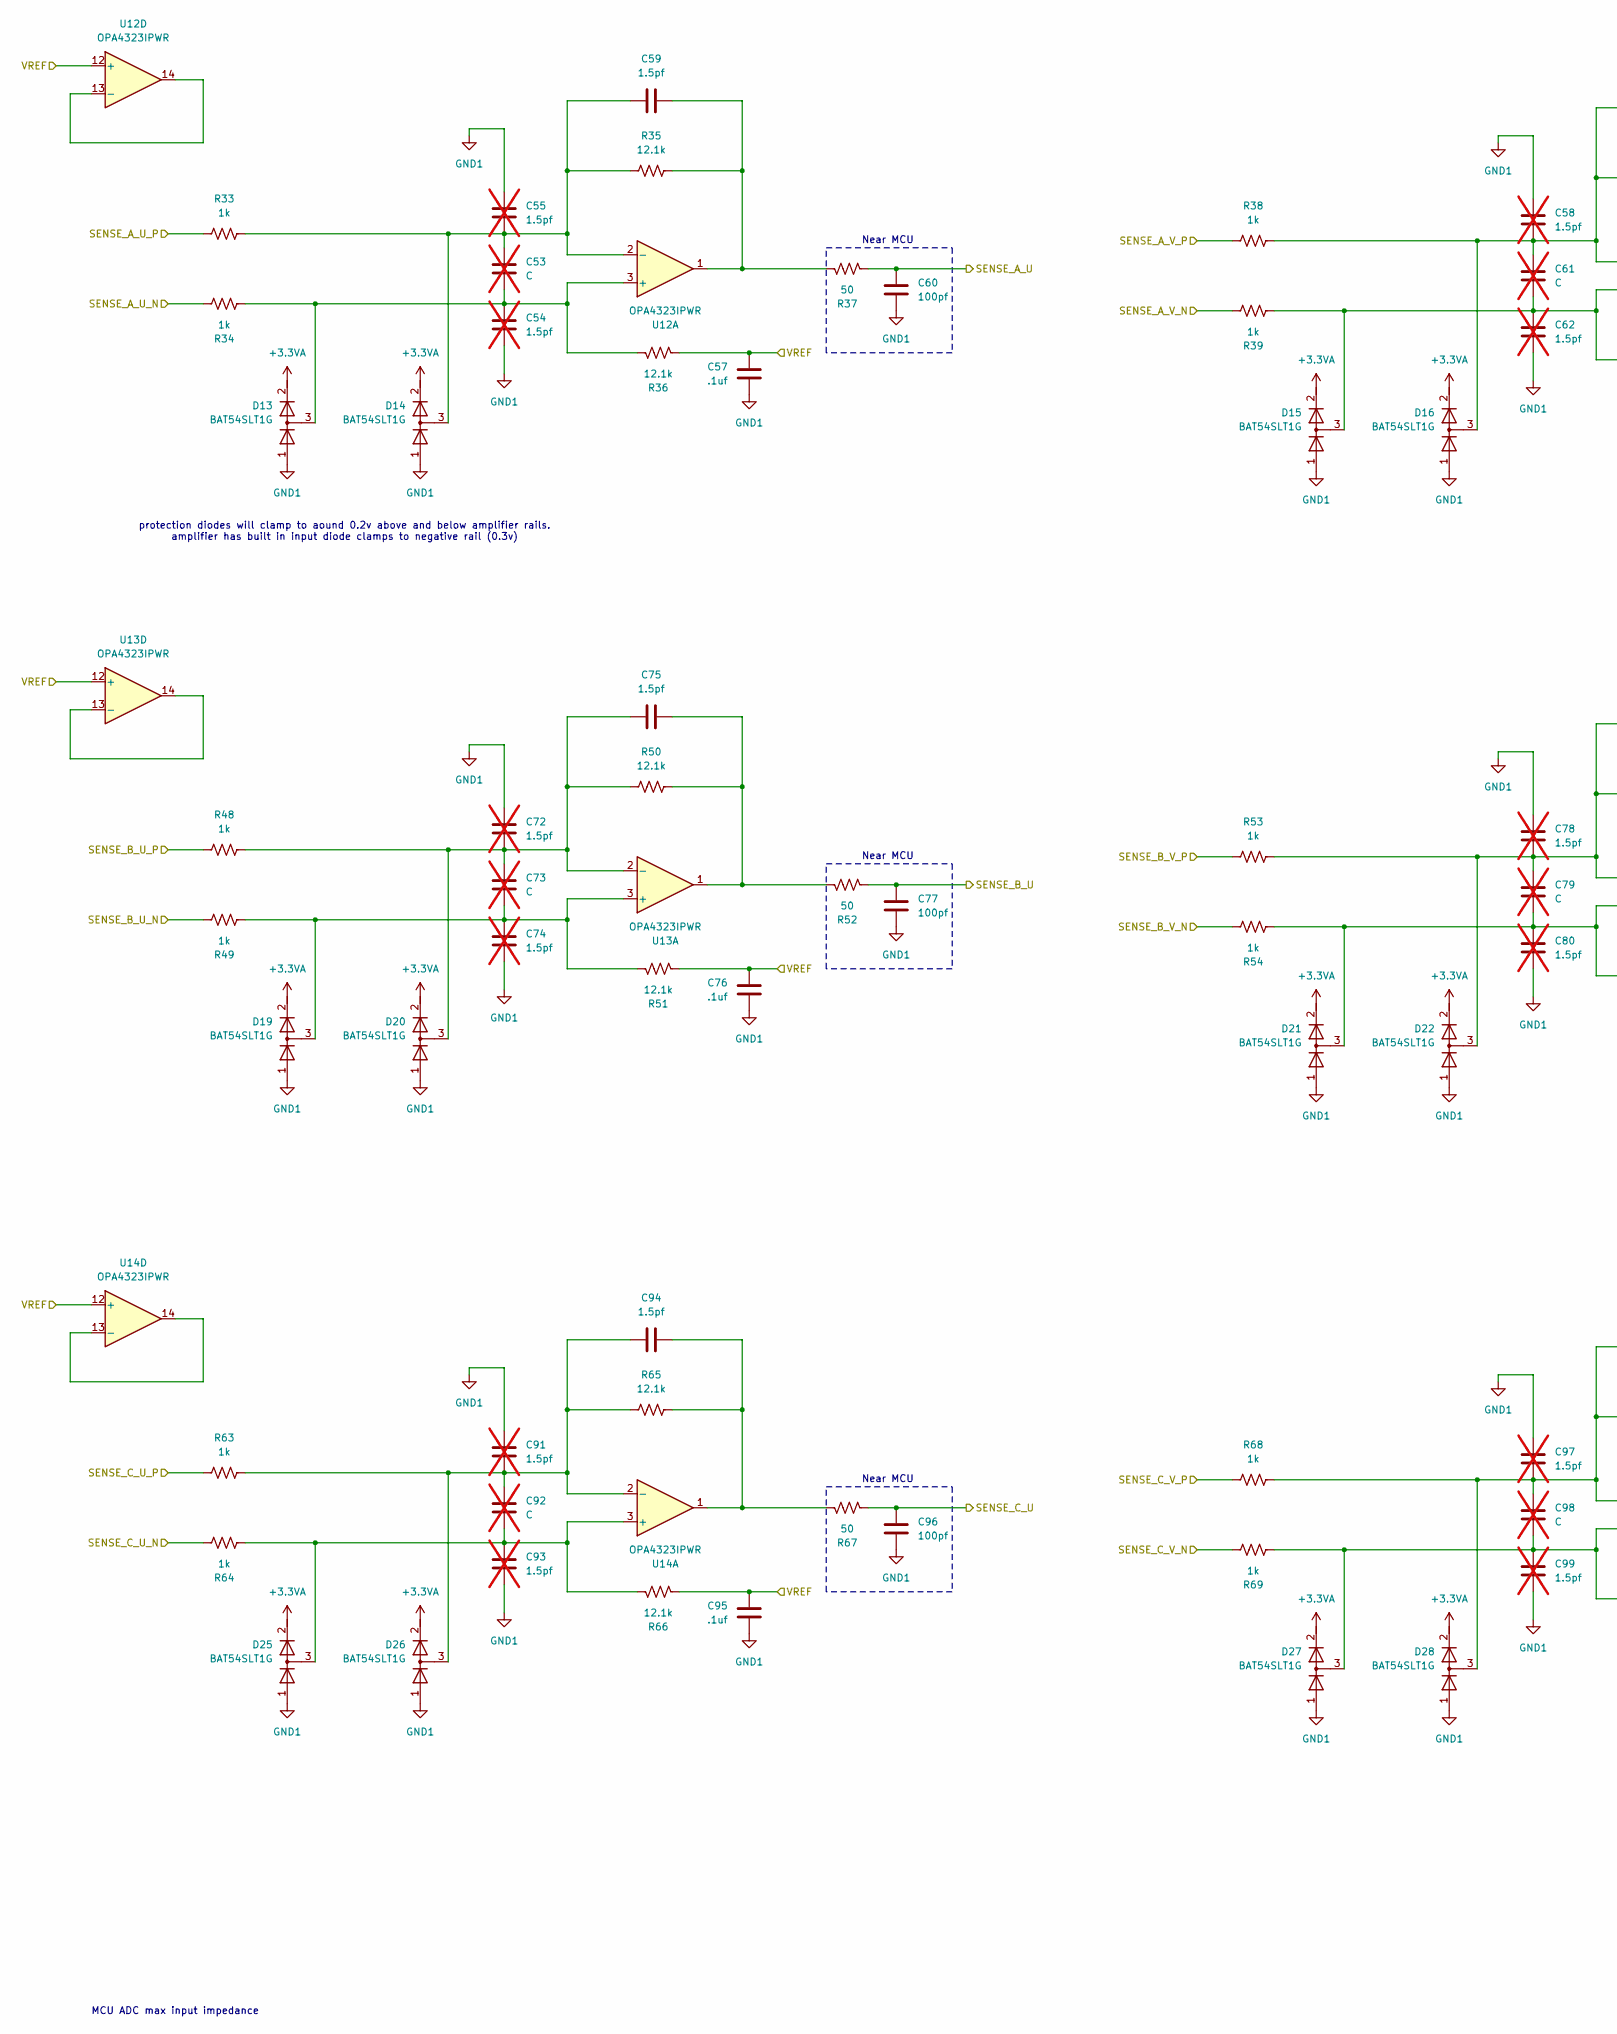
[picture p11: schematic current_sense.kicad_sch, part in row 1, column 1]

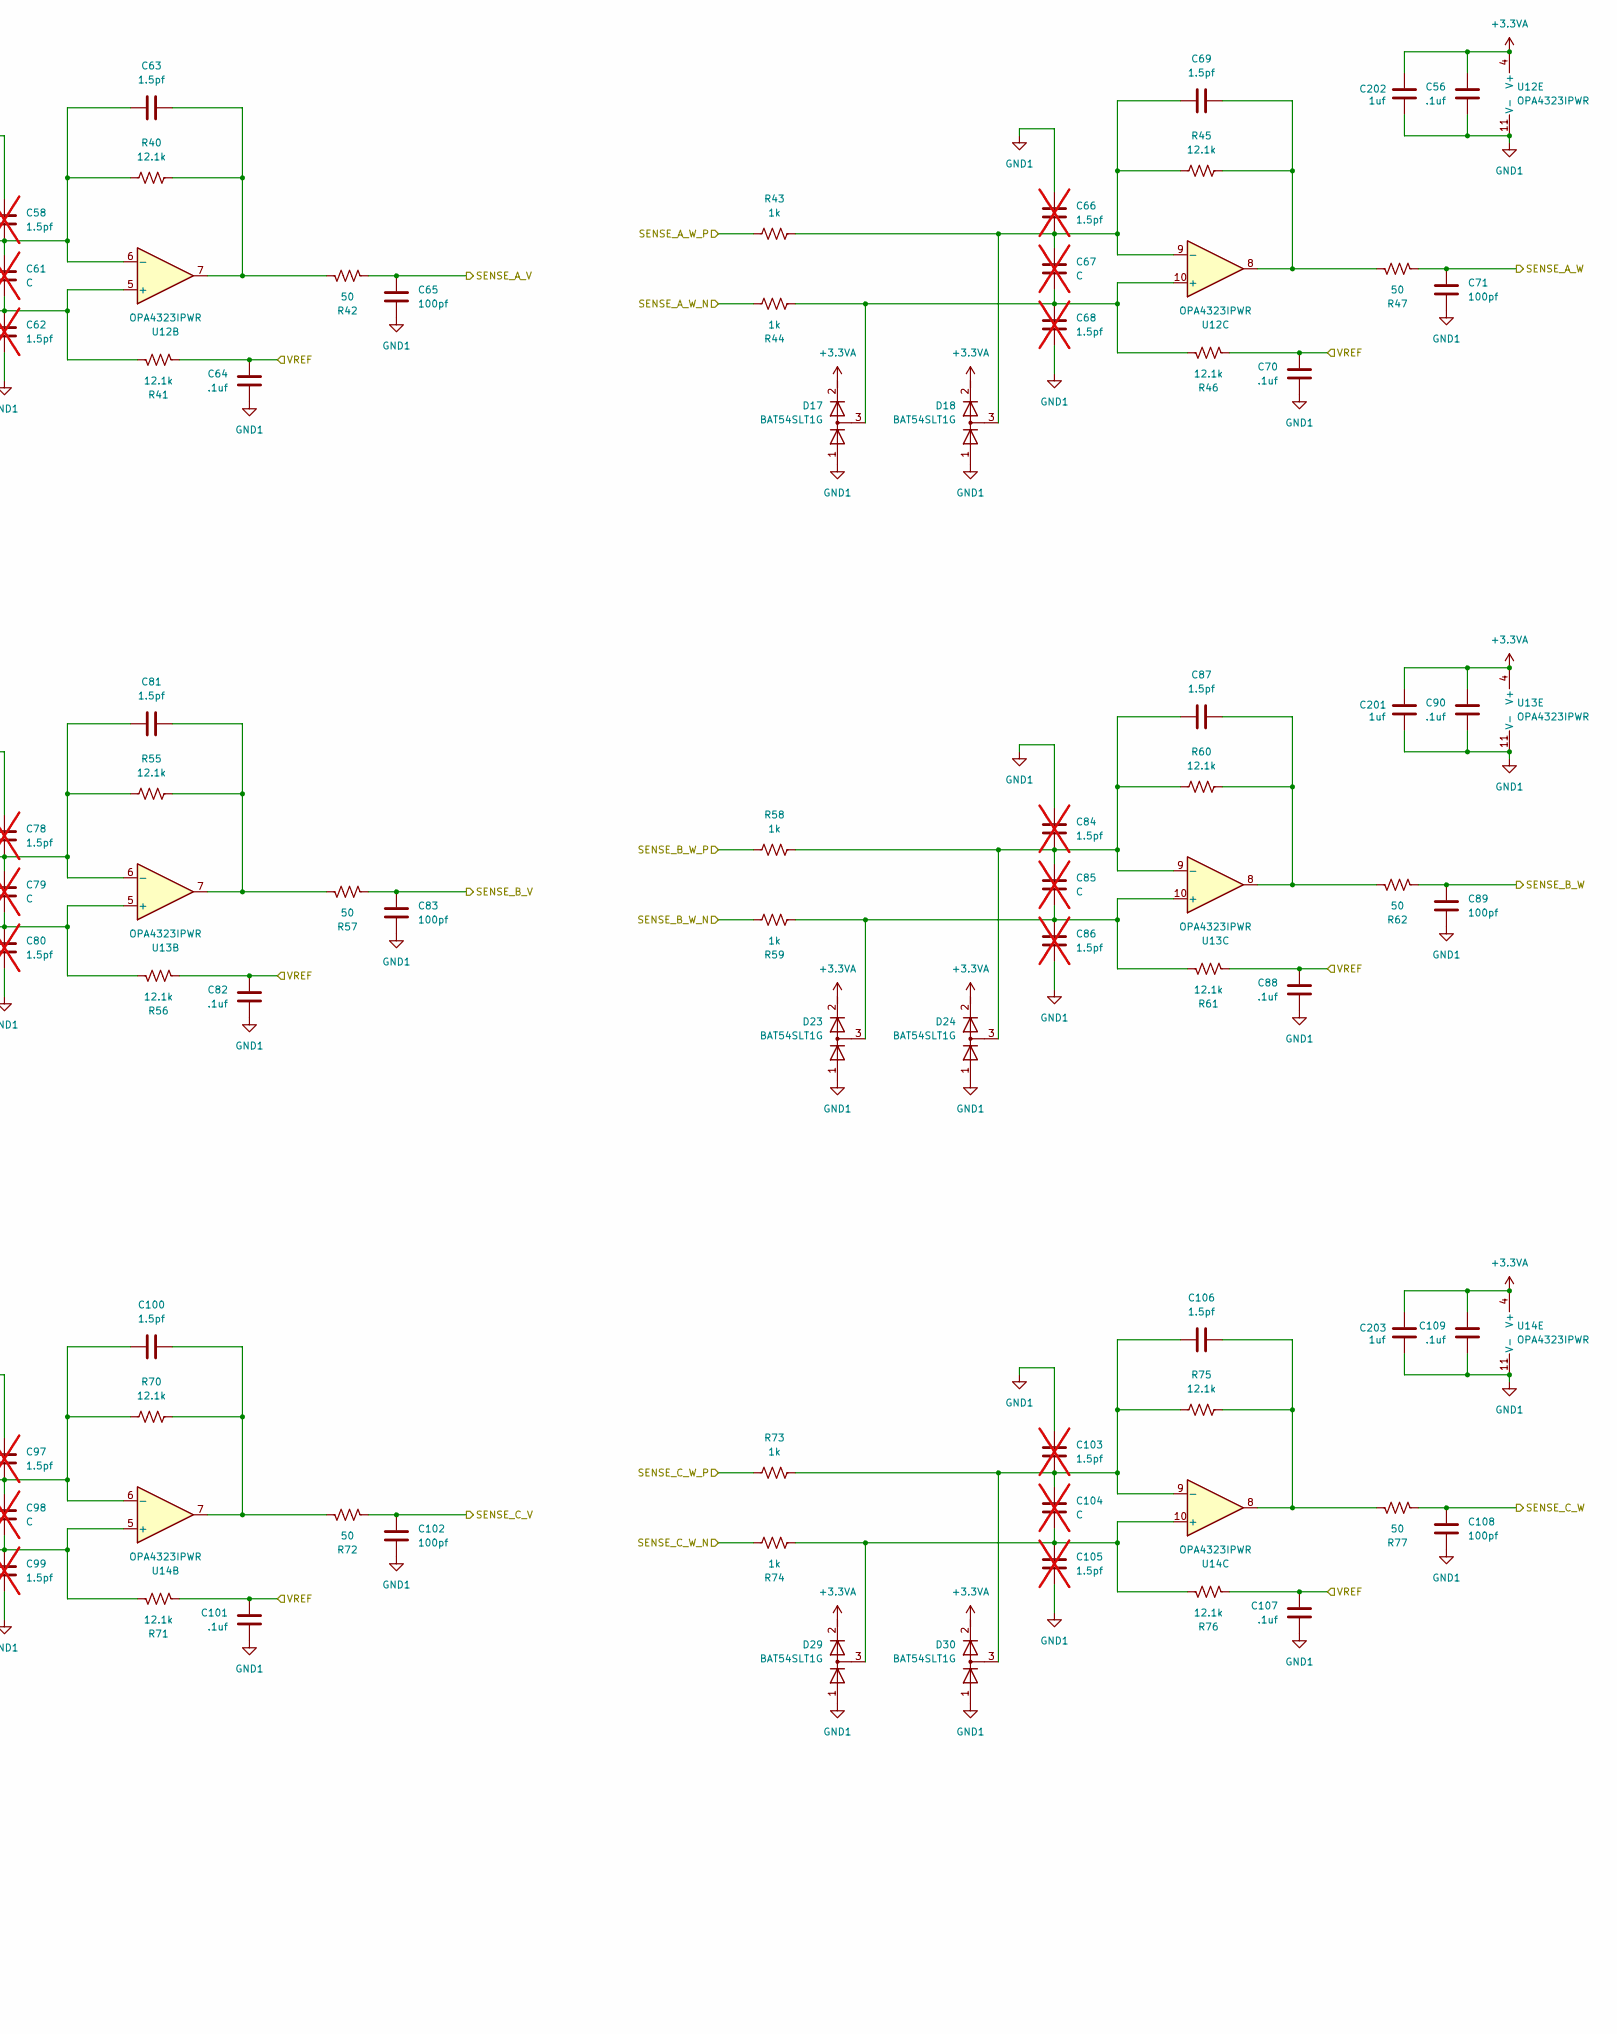
[picture p12: schematic current_sense.kicad_sch, part in row 1, column 2]

Parts:
C53, C61, C67, C73, C79, C85, C92, C98, C104: C; C_0402_1005Metric; not fitted
C54, C55, C58, C62, C66, C68, C72, C74, C78, C80, C84, C86, C91, C93, C97, C99, C103, C105: 1.5pf; C_0402_1005Metric; Part number CC0402BRNPO9BN1R5; LCSC# C282238; not fitted
C56, C57, C64, C70, C76, C82, C88, C90, C95, C101, C107, C109: .1uf; C_0402_1005Metric; Part number CC0402KRX5R9BB104; LCSC# C105882
C59, C63, C69, C75, C81, C87, C94, C100, C106: 1.5pf; C_0402_1005Metric; Part number CC0402BRNPO9BN1R5; LCSC# C282238
C60, C65, C71, C77, C83, C89, C96, C102, C108: 100pf; C_0402_1005Metric; Part number CC0402JRNPO9BN101; LCSC# C106200
C201, C202, C203: 1uf; C_0402_1005Metric; Part number CL05A105KP5NNNC; LCSC# C14445
D13, D14, D15, D16, D17, D18, D19, D20, D21, D22, D23, D24, D25, D26, D27, D28, D29, D30: BAT54SLT1G; SOT-23; Part number LBAT54SLT1G; LCSC# C12765
R33, R34, R38, R39, R43, R44, R48, R49, R53, R54, R58, R59, R63, R64, R68, R69, R73, R74: 1k; R_0402_1005Metric; Part number RC0402FR-071KL; LCSC# C106235
R35, R36, R40, R41, R45, R46, R50, R51, R55, R56, R60, R61, R65, R66, R70, R71, R75, R76: 12.1k; R_0402_1005Metric; Part number RC0402FR-0712K1L; LCSC# C132157
R37, R42, R47, R52, R57, R62, R67, R72, R77: 50; R_0402_1005Metric; Part number RC0402JR-0750RL; LCSC# C477760
U12, U13, U14: OPA4323IPWR; TSSOP-14_4.4x5mm_P0.65mm; Part number OPA4323IPWR; LCSC# C22419728

Connections:
+3.3VA: C56.1, C90.1, C109.1, C201.2, C202.2, C203.2, D13.2 (K), D14.2 (K), D15.2 (K), D16.2 (K), D17.2 (K), D18.2 (K), D19.2 (K), D20.2 (K), D21.2 (K), D22.2 (K), D23.2 (K), D24.2 (K), D25.2 (K), D26.2 (K), D27.2 (K), D28.2 (K), D29.2 (K), D30.2 (K), U12.4 (V+), U13.4 (V+), U14.4 (V+); also elsewhere on the board
/Current Sense/SENSE_A_U: C60.1, R37.2; also elsewhere on the board
/Current Sense/SENSE_A_V: C65.1, R42.2; also elsewhere on the board
/Current Sense/SENSE_A_W: C71.1, R47.2; also elsewhere on the board
/Current Sense/SENSE_B_U: C77.1, R52.2; also elsewhere on the board
/Current Sense/SENSE_B_V: C83.1, R57.2; also elsewhere on the board
/Current Sense/SENSE_B_W: C89.1, R62.2; also elsewhere on the board
/Current Sense/SENSE_C_U: C96.1, R67.2; also elsewhere on the board
/Current Sense/SENSE_C_V: C102.1, R72.2; also elsewhere on the board
/Current Sense/SENSE_C_W: C108.1, R77.2; also elsewhere on the board
/MOTOR_A.U_N: R34.2; also elsewhere on the board
/MOTOR_A.U_P: R33.1; also elsewhere on the board
/MOTOR_A.V_N: R39.2; also elsewhere on the board
/MOTOR_A.V_P: R38.1; also elsewhere on the board
/MOTOR_A.W_N: R44.2; also elsewhere on the board
/MOTOR_A.W_P: R43.1; also elsewhere on the board
/MOTOR_B.U_N: R49.2; also elsewhere on the board
/MOTOR_B.U_P: R48.1; also elsewhere on the board
/MOTOR_B.V_N: R54.2; also elsewhere on the board
/MOTOR_B.V_P: R53.1; also elsewhere on the board
/MOTOR_B.W_N: R59.2; also elsewhere on the board
/MOTOR_B.W_P: R58.1; also elsewhere on the board
/MOTOR_C.U_N: R64.2; also elsewhere on the board
/MOTOR_C.U_P: R63.1; also elsewhere on the board
/MOTOR_C.V_N: R69.2; also elsewhere on the board
/MOTOR_C.V_P: R68.1; also elsewhere on the board
/MOTOR_C.W_N: R74.2; also elsewhere on the board
/MOTOR_C.W_P: R73.1; also elsewhere on the board
/Microcontroller/VREF_HALF: C57.1, C64.1, C70.1, C76.1, C82.1, C88.1, C95.1, C101.1, C107.1, R36.2, R41.2, R46.2, R51.2, R56.2, R61.2, R66.2, R71.2, R76.2, U12.12 (+), U13.12 (+), U14.12 (+); also elsewhere on the board
unnamed: C59.2, R35.2, R37.1, U12.1
unnamed: C63.2, R40.2, R42.1, U12.7
unnamed: C69.2, R45.2, R47.1, U12.8
unnamed: C75.2, R50.2, R52.1, U13.1
unnamed: C81.2, R55.2, R57.1, U13.7
unnamed: C87.2, R60.2, R62.1, U13.8
unnamed: C94.2, R65.2, R67.1, U14.1
unnamed: C100.2, R70.2, R72.1, U14.7
unnamed: C106.2, R75.2, R77.1, U14.8
unnamed: C53.2, C54.1, D13.3 (common), R34.1, R36.1, U12.3 (+)
unnamed: C53.1, C55.2, C59.1, D14.3 (common), R33.2, R35.1, U12.2 (-)
unnamed: C61.2, C62.1, D15.3 (common), R39.1, R41.1, U12.5 (+)
unnamed: C58.2, C61.1, C63.1, D16.3 (common), R38.2, R40.1, U12.6 (-)
unnamed: C67.2, C68.1, D17.3 (common), R44.1, R46.1, U12.10 (+)
unnamed: C66.2, C67.1, C69.1, D18.3 (common), R43.2, R45.1, U12.9 (-)
unnamed: C73.2, C74.1, D19.3 (common), R49.1, R51.1, U13.3 (+)
unnamed: C72.2, C73.1, C75.1, D20.3 (common), R48.2, R50.1, U13.2 (-)
unnamed: C79.2, C80.1, D21.3 (common), R54.1, R56.1, U13.5 (+)
unnamed: C78.2, C79.1, C81.1, D22.3 (common), R53.2, R55.1, U13.6 (-)
unnamed: C85.2, C86.1, D23.3 (common), R59.1, R61.1, U13.10 (+)
unnamed: C84.2, C85.1, C87.1, D24.3 (common), R58.2, R60.1, U13.9 (-)
unnamed: C92.2, C93.1, D25.3 (common), R64.1, R66.1, U14.3 (+)
unnamed: C91.2, C92.1, C94.1, D26.3 (common), R63.2, R65.1, U14.2 (-)
unnamed: C98.2, C99.1, D27.3 (common), R69.1, R71.1, U14.5 (+)
unnamed: C97.2, C98.1, C100.1, D28.3 (common), R68.2, R70.1, U14.6 (-)
unnamed: C104.2, C105.1, D29.3 (common), R74.1, R76.1, U14.10 (+)
unnamed: C103.2, C104.1, C106.1, D30.3 (common), R73.2, R75.1, U14.9 (-)
unnamed: U12.13 (-), U12.14
unnamed: U13.13 (-), U13.14
unnamed: U14.13 (-), U14.14

Notes on the sheet:
protection diodes will clamp to aound 0.2v above and below amplifier rails. amplifier has built in input diode clamps to negative rail (0.3v)
Near MCU
MCU ADC max input impedance
