ExcessiveOverkill/hvsd-3ch/KiCad/high voltage servo drive 3ch/high voltage servo drive 3ch.kicad_pcb

## KiCad design KiCad/high voltage servo drive 3ch/high voltage servo drive 3ch.kicad_pcb (continued)

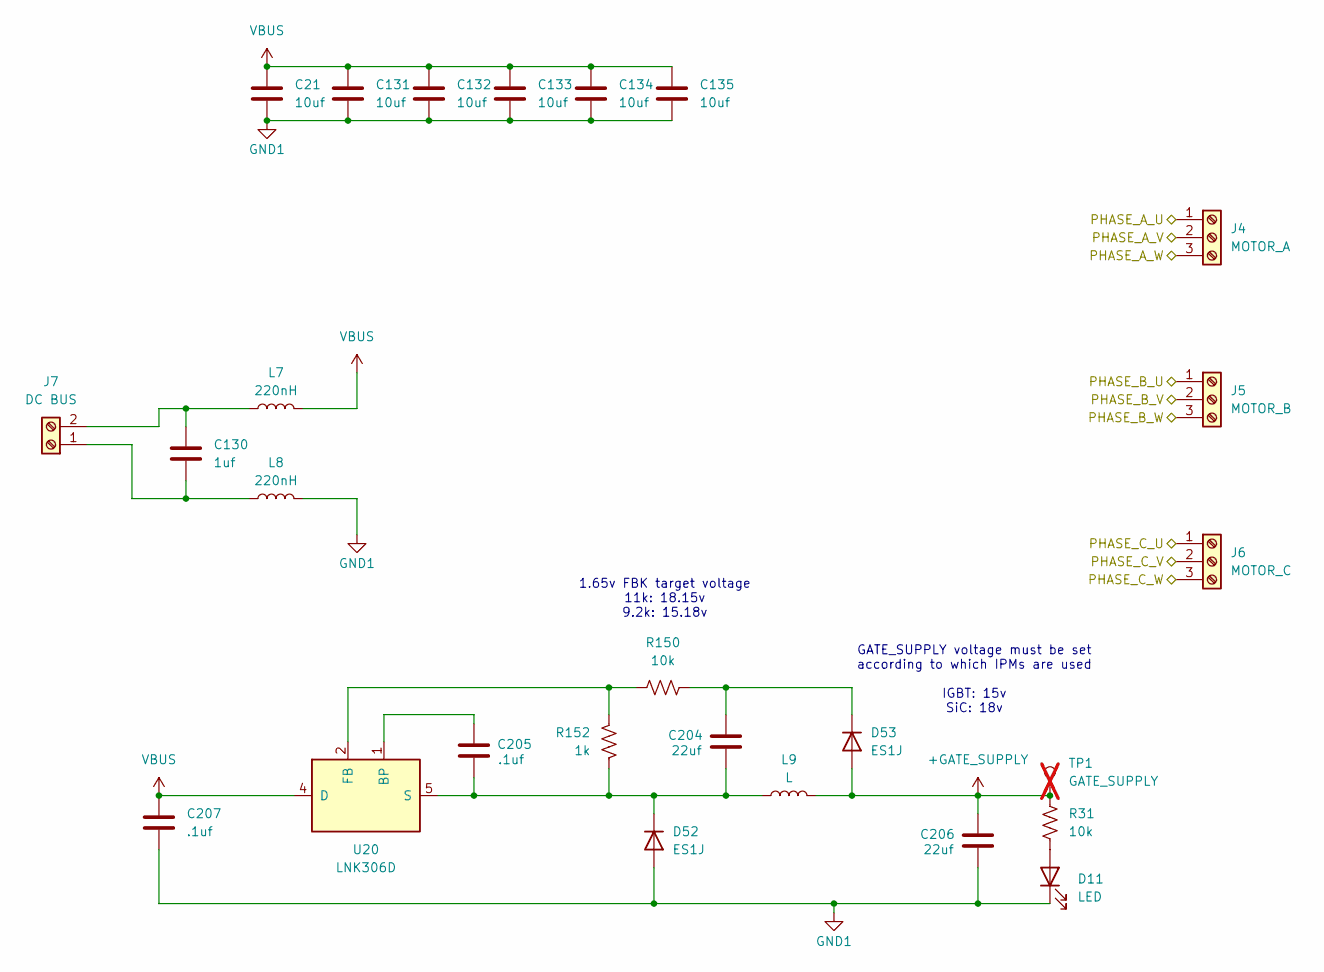
[picture p13: schematic power_connectors.kicad_sch]

Parts:
C21, C131, C132, C133, C134, C135: 10uf; C_Rect_L32mm_W16.0mm_P27.50mm; LCSC# C48533427
C130: 1uf; C_Rect_L26.5mm_W10.5mm_P22.50mm_MKS4; Part number MPB105J2J2201; LCSC# C2928857
C204, C206: 22uf; C_1206_3216Metric; Part number CL31A226KAHNNNE; LCSC# C12891
C205: .1uf; C_0402_1005Metric; Part number CC0402KRX5R9BB104; LCSC# C105882
C207: .1uf; C_1812_4532Metric; Part number NV1812B104K102CEMN; LCSC# C780707
D11: LED; LED_0603_1608Metric; Part number XL-1608UBC-04; LCSC# C965807
D52, D53: ES1J; D_SMA; Part number ES1J; LCSC# C908655
J4: MOTOR_A; DB3ERC-7.62-3P; Part number DB3ERC-7.62-3P-GN; LCSC# C7422679
J5: MOTOR_B; DB3ERC-7.62-3P; Part number DB3ERC-7.62-3P-GN; LCSC# C7422679
J6: MOTOR_C; DB3ERC-7.62-3P; Part number DB3ERC-7.62-3P-GN; LCSC# C7422679
J7: DC BUS; DB3ERC-7.62-2P; Part number DB3ERC-7.62-2P-GN; LCSC# C7422678
L7, L8: 220nH; MS1050; Part number MS1050-R22M; LCSC# C18337500
L9: L; L_Radial_D7.2mm_P3.00mm_Murata_1700; Part number PDPTAT0608-102K; LCSC# C5119606
R31, R150: 10k; R_0402_1005Metric; Part number RC0402FR-0710KL; LCSC# C60490
R152: 1k; R_0402_1005Metric; Part number RC0402FR-071KL; LCSC# C106235
TP1: GATE_SUPPLY; TestPoint_Pad_D2.0mm; not fitted
U20: LNK306D; PowerIntegrations_SO-8B; Part number LNK306DG-TL; LCSC# C394187

Connections:
+GATE_SUPPLY: C206.2, D53.2 (A), L9.2, R31.2, TP1.1; also elsewhere on the board
/Inverter A/U: J4.1; also elsewhere on the board
/Inverter A/V: J4.2; also elsewhere on the board
/Inverter A/W: J4.3; also elsewhere on the board
/Inverter B/U: J5.1; also elsewhere on the board
/Inverter B/V: J5.2; also elsewhere on the board
/Inverter B/W: J5.3; also elsewhere on the board
/Inverter C/U: J6.1; also elsewhere on the board
/Inverter C/V: J6.2; also elsewhere on the board
/Inverter C/W: J6.3; also elsewhere on the board
unnamed: D11.2 (A), R31.1
unnamed: C204.1, C205.1, D52.1 (K), L9.1, R152.1, U20.5 (S), U20.6 (S), U20.7 (S), U20.8 (S)
unnamed: C204.2, D53.1 (K), R150.2
unnamed: C130.2, J7.1, L8.1
unnamed: C130.1, J7.2, L7.1
unnamed: C205.2, U20.1 (BP)
unnamed: R150.1, R152.2, U20.2 (FB)
VBUS: C21.1, C131.1, C132.1, C133.1, C134.1, C135.1, C207.1, L7.2, U20.4 (D); also elsewhere on the board

Notes on the sheet:
1.65v FBK target voltage 11k: 18.15v 9.2k: 15.18v
GATE_SUPPLY voltage must be set according to which IPMs are used IGBT: 15v SiC: 18v

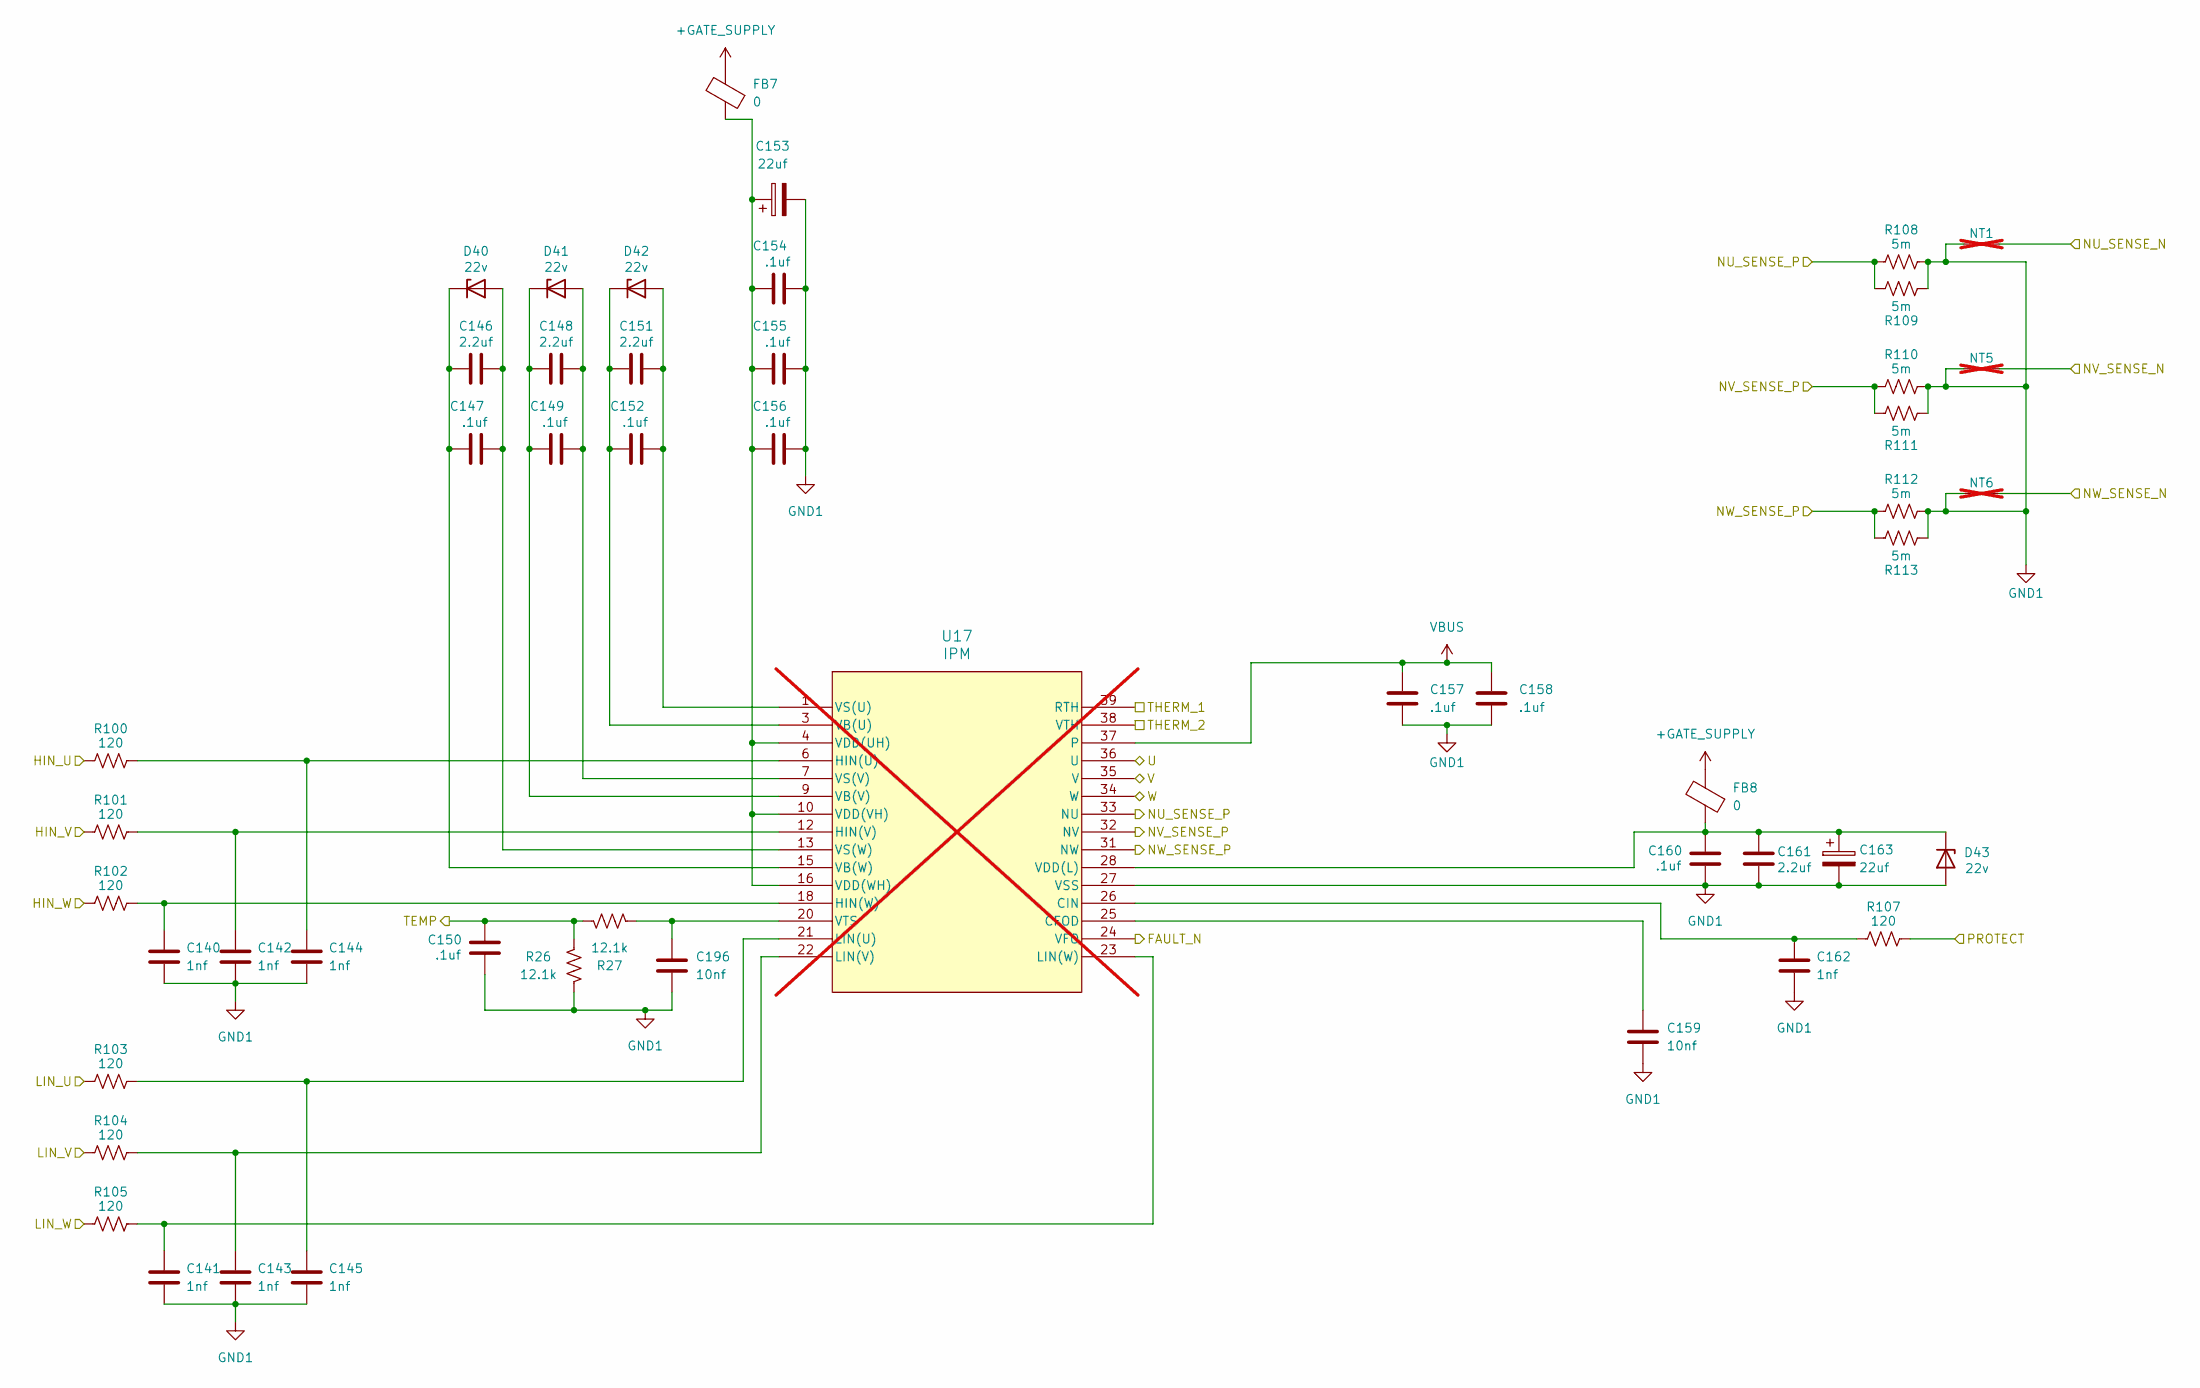
[picture p14: schematic inverter_B.kicad_sch]

Parts:
C140, C141, C142, C143, C144, C145, C162: 1nf; C_0402_1005Metric; Part number CC0402KRX7R9BB102; LCSC# C106205
C146, C148, C151, C161: 2.2uf; C_1206_3216Metric; Part number CL31B225KBHNNNE; LCSC# C50254
C147, C149, C150, C152, C154, C155, C156, C160: .1uf; C_0402_1005Metric; Part number CC0402KRX5R9BB104; LCSC# C105882
C153, C163: 22uf; CP_Elec_6.3x5.9; Part number 189RV0014; LCSC# C7471876
C157, C158: .1uf; C_1812_4532Metric; Part number NV1812B104K102CEMN; LCSC# C780707
C159, C196: 10nf; C_0402_1005Metric; Part number CC0402KRX7R9BB103; LCSC# C60133
D40, D41, D42, D43: 22v; D_SMA; Part number SMA2Z22A; LCSC# C7440711
FB7, FB8: 0; L_0805_2012Metric; Part number FRC0805P000 TS; LCSC# C2907288
NT1, NT5, NT6: NetTie_2; NetTie-2_SMD_Pad0.2mm; not fitted
R26, R27: 12.1k; R_0402_1005Metric; Part number RC0402FR-0712K1L; LCSC# C132157
R100, R101, R102, R103, R104, R105, R107: 120; R_0402_1005Metric; Part number RC0402FR-07120RL; LCSC# C114758
R108, R109, R110, R111, R112, R113: 5m; R_1206_3216Metric; Part number FRM121WFR005TM; LCSC# C7419996
U17: IPM; DIP39_54.5X31.0_MODGC_OSI; not fitted

Connections:
+GATE_SUPPLY: FB7.2, FB8.2; also elsewhere on the board
/INVERTER_B_FAULT: U17.24 (VFO); also elsewhere on the board
/INVERTER_B_TEMP: C150.2, R26.1, R27.1; also elsewhere on the board
/INVERTER_DISABLE: R107.2; also elsewhere on the board
/Inverter B/THERM_1: U17.39 (RTH); also elsewhere on the board
/Inverter B/U: U17.36 (U); also elsewhere on the board
/Inverter B/V: U17.35 (V); also elsewhere on the board
/Inverter B/W: U17.34 (W); also elsewhere on the board
/MOTOR_B.HIN_U: R100.1; also elsewhere on the board
/MOTOR_B.HIN_V: R101.1; also elsewhere on the board
/MOTOR_B.HIN_W: R102.1; also elsewhere on the board
/MOTOR_B.LIN_U: R103.1; also elsewhere on the board
/MOTOR_B.LIN_V: R104.1; also elsewhere on the board
/MOTOR_B.LIN_W: R105.1; also elsewhere on the board
/MOTOR_B.U_N: NT1.2; also elsewhere on the board
/MOTOR_B.U_P: R108.1, R109.2, U17.33 (NU); also elsewhere on the board
/MOTOR_B.V_N: NT5.2; also elsewhere on the board
/MOTOR_B.V_P: R110.1, R111.2, U17.32 (NV); also elsewhere on the board
/MOTOR_B.W_N: NT6.2; also elsewhere on the board
/MOTOR_B.W_P: R112.1, R113.2, U17.31 (NW); also elsewhere on the board
/Microcontroller/INVERTER_B_THERM: U17.38 (VTH); also elsewhere on the board
unnamed: C146.2, C147.2, D40.2 (A), U17.13 (VS(W))
unnamed: C146.1, C147.1, D40.1 (K), U17.15 (VB(W))
unnamed: C148.2, C149.2, D41.2 (A), U17.7 (VS(V))
unnamed: C148.1, C149.1, D41.1 (K), U17.9 (VB(V))
unnamed: C151.2, C152.2, D42.2 (A), U17.1 (VS(U))
unnamed: C151.1, C152.1, D42.1 (K), U17.3 (VB(U))
unnamed: C160.2, C161.1, C163.1, D43.1 (K), FB8.1, U17.28 (VDD(L))
unnamed: C159.1, U17.25 (CFOD)
unnamed: C162.1, R107.1, U17.26 (CIN)
unnamed: C144.1, R100.2, U17.6 (HIN(U))
unnamed: C142.1, R101.2, U17.12 (HIN(V))
unnamed: C140.1, R102.2, U17.18 (HIN(W))
unnamed: C145.1, R103.2, U17.21 (LIN(U))
unnamed: C143.1, R104.2, U17.22 (LIN(V))
unnamed: C141.1, R105.2, U17.23 (LIN(W))
unnamed: C153.1, C154.1, C155.1, C156.1, FB7.1, U17.4 (VDD(UH)), U17.10 (VDD(VH)), U17.16 (VDD(WH))
unnamed: C196.1, R27.2, U17.20 (VTS)
VBUS: C157.1, C158.1, U17.37; also elsewhere on the board

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
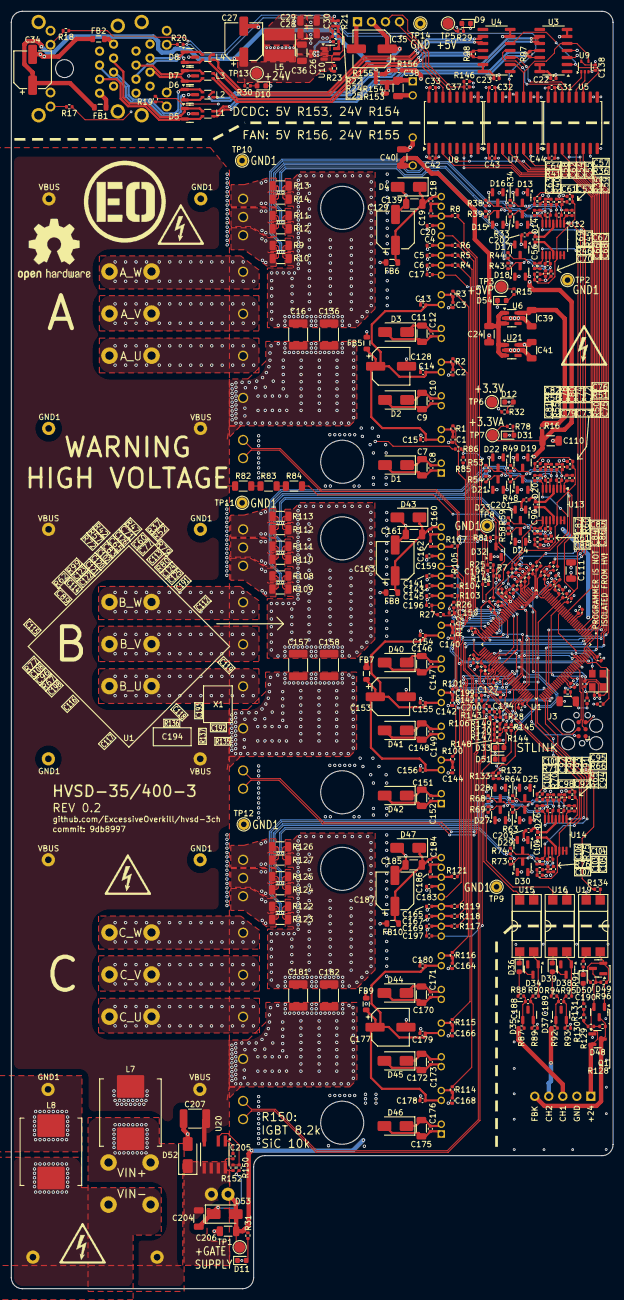
[picture p15: board high voltage servo drive 3ch.kicad_pcb from above]

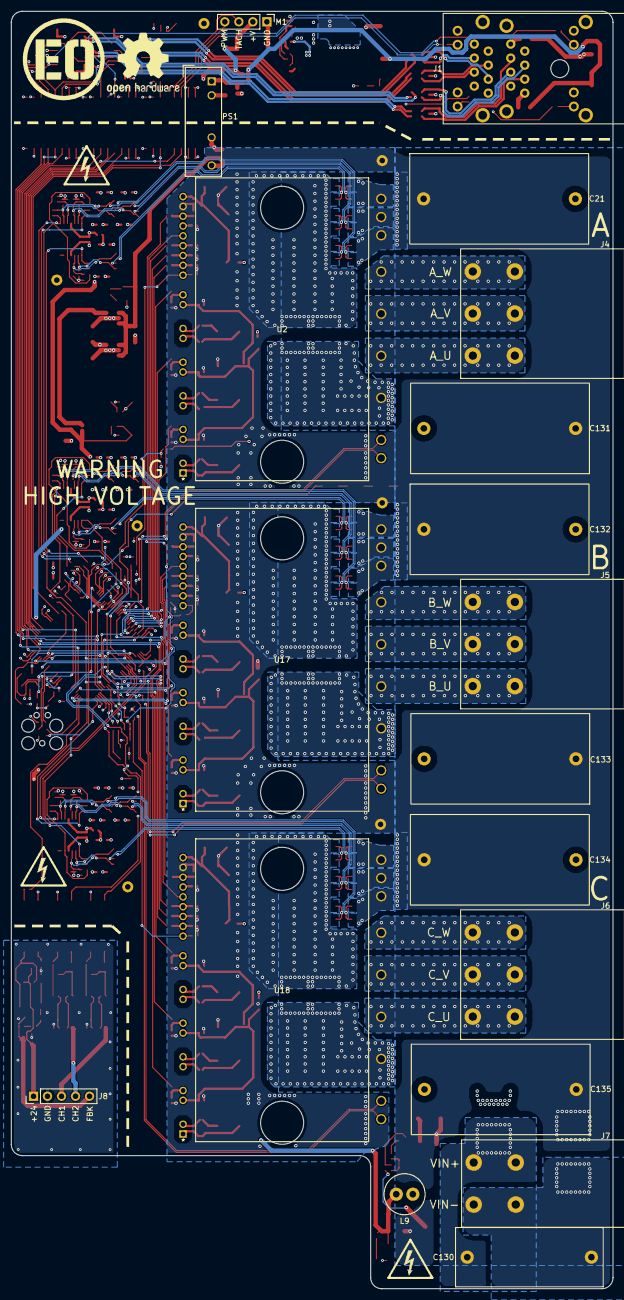
[picture p16: board high voltage servo drive 3ch.kicad_pcb from below]

Board: 4 copper layers, 109.0 x 231.4 mm, 476 parts (28 on the bottom side), 266 nets.

Other parts of the board:
C188, C189, C190: .1uf; C_0402_1005Metric
D34, D38, D48: BAT54SLT1G; SOT-23
D35, D37, D49: SM712; SOT-23
D36, D39, D50: LED; LED_0603_1608Metric
J8: STO; PinHeader_1x05_P2.54mm_Vertical
Q1: BSS83P; SOT-23
R16: 0; R_0402_1005Metric
R87, R88, R89, R90, R92, R93, R94, R95, R128, R129, R130, R131, R134: 1k; R_0402_1005Metric
R91, R96, R132, R133: 10k; R_0402_1005Metric
U15, U16, U19: PC-817S1-CTP1-F

Their connections:
+3.3V: R132.2, R133.2; also elsewhere on the board
+3.3VA: R16.1; also elsewhere on the board
+24V_STO: C190.2, D48.2 (K), D49.3 (common), J8.1, Q1.2 (S), R96.2
/PWM_DISABLE_1: R133.1, U15.4; also elsewhere on the board
/PWM_DISABLE_2: R132.1, U16.4; also elsewhere on the board
/STO/CH1: J8.3, R87.1
/STO/CH2: J8.4, R92.1
/STO/FBK: D48.3 (common), J8.5, Q1.3 (D), R128.2
/STO_FBK: R134.1; also elsewhere on the board
GND2: D48.1 (A), D50.1 (K), J8.2, R89.1, R91.1, R93.1
unnamed: D34.1 (A), R90.2, U15.2
unnamed: D34.3 (common), D36.2 (A), R88.2
unnamed: C188.2, D35.1 (A1), R87.2, R88.1
unnamed: C188.1, D35.2 (A2), R89.2, R90.1
unnamed: D36.1 (K), U15.1
unnamed: C189.2, D37.1 (A1), R92.2, R94.1
unnamed: C189.1, D37.2 (A2), R93.2, R95.1
unnamed: D38.1 (A), R95.2, U16.2
unnamed: D38.3 (common), D39.2 (A), R94.2
unnamed: D39.1 (K), U16.1
unnamed: C190.1, D49.2 (A2), Q1.1 (G), R96.1, U19.4
unnamed: D50.2 (A), R131.1
unnamed: R91.2, U19.3
unnamed: R128.1, R129.2
unnamed: R129.1, R130.2
unnamed: R130.1, R131.2
unnamed: R134.2, U19.1
unnamed 235: R16.2; also elsewhere on the board
