ExcessiveOverkill/hvsd-3ch/stm32/Core/Src/main.c

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
/* Includes ------------------------------------------------------------------*/
#include "main.h"

ADC_HandleTypeDef hadc1;
ADC_HandleTypeDef hadc2;
ADC_HandleTypeDef hadc3;
ADC_HandleTypeDef hadc4;

CORDIC_HandleTypeDef hcordic;

CRC_HandleTypeDef hcrc;

FDCAN_HandleTypeDef hfdcan1;

FMAC_HandleTypeDef hfmac;

I2C_HandleTypeDef hi2c3;

OPAMP_HandleTypeDef hopamp5;

SPI_HandleTypeDef hspi3;

TIM_HandleTypeDef htim1;
TIM_HandleTypeDef htim2;
TIM_HandleTypeDef htim3;
TIM_HandleTypeDef htim5;
TIM_HandleTypeDef htim8;
TIM_HandleTypeDef htim15;
TIM_HandleTypeDef htim17;
TIM_HandleTypeDef htim20;

UART_HandleTypeDef huart1;
UART_HandleTypeDef huart2;
UART_HandleTypeDef huart3;

void SystemClock_Config(void);
static void MX_GPIO_Init(void);
static void MX_TIM1_Init(void);
static void MX_TIM8_Init(void);
static void MX_TIM20_Init(void);
static void MX_ADC1_Init(void);
static void MX_ADC2_Init(void);
static void MX_ADC3_Init(void);
static void MX_CORDIC_Init(void);
static void MX_CRC_Init(void);
static void MX_FMAC_Init(void);
static void MX_TIM2_Init(void);
static void MX_TIM3_Init(void);
static void MX_USART1_UART_Init(void);
static void MX_OPAMP5_Init(void);
static void MX_FDCAN1_Init(void);
static void MX_I2C3_Init(void);
static void MX_SPI3_Init(void);
static void MX_TIM5_Init(void);
static void MX_TIM15_Init(void);
static void MX_TIM17_Init(void);
static void MX_USART2_UART_Init(void);
static void MX_USART3_UART_Init(void);
static void MX_ADC4_Init(void);
/**
  * @brief  The application entry point.
  * @retval int
  */
int main(void)
{

  /* MCU Configuration--------------------------------------------------------*/

  /* Reset of all peripherals, Initializes the Flash interface and the Systick. */
  HAL_Init();

  /* Configure the system clock */
  SystemClock_Config();

  /* Initialize all configured peripherals */
  MX_GPIO_Init();
  MX_TIM1_Init();
  MX_TIM8_Init();
  MX_TIM20_Init();
  MX_ADC1_Init();
  MX_ADC2_Init();
  MX_ADC3_Init();
  MX_CORDIC_Init();
  MX_CRC_Init();
  MX_FMAC_Init();
  MX_TIM2_Init();
  MX_TIM3_Init();
  MX_USART1_UART_Init();
  MX_OPAMP5_Init();
  MX_FDCAN1_Init();
  MX_I2C3_Init();
  MX_SPI3_Init();
  MX_TIM5_Init();
  MX_TIM15_Init();
  MX_TIM17_Init();
  MX_USART2_UART_Init();
  MX_USART3_UART_Init();
  MX_ADC4_Init();
  /* USER CODE BEGIN 2 */

  HAL_TIM_PWM_Start(&htim17, TIM_CHANNEL_1);

  /* USER CODE END 2 */

  /* Infinite loop */
  /* USER CODE BEGIN WHILE */
  while (1)
  {

	for(uint16_t val = 0; val < 999; val++){
		TIM17->CCR1 = val;
		HAL_Delay(20);
	}

	for(uint16_t val = 999; val > 0; val--){
		TIM17->CCR1 = val;
		HAL_Delay(20);
	}

//	// port 1 led 0
//	HAL_GPIO_WritePin(GPIOE, GPIO_PIN_6, GPIO_PIN_SET);
//	HAL_Delay(500);
//
//	HAL_GPIO_WritePin(GPIOE, GPIO_PIN_6, GPIO_PIN_RESET);
//	HAL_Delay(500);
//
//	// port 1 led 1
//	HAL_GPIO_WritePin(GPIOE, GPIO_PIN_5, GPIO_PIN_SET);
//	HAL_Delay(500);
//
//	HAL_GPIO_WritePin(GPIOE, GPIO_PIN_5, GPIO_PIN_RESET);
//	HAL_Delay(500);
//
//	// port 2 led 0
//	HAL_GPIO_WritePin(GPIOC, GPIO_PIN_13, GPIO_PIN_SET);
//	HAL_Delay(500);
//
//	HAL_GPIO_WritePin(GPIOC, GPIO_PIN_13, GPIO_PIN_RESET);
//	HAL_Delay(500);
//
//	// port 2 led 1
//	HAL_GPIO_WritePin(GPIOE, GPIO_PIN_4, GPIO_PIN_SET);
//	HAL_Delay(500);
//
//	HAL_GPIO_WritePin(GPIOE, GPIO_PIN_4, GPIO_PIN_RESET);
//	HAL_Delay(500);
//
//	// port 1 led 1
//	HAL_GPIO_WritePin(GPIOA, GPIO_PIN_11, GPIO_PIN_SET);
//	HAL_Delay(500);
//
//	HAL_GPIO_WritePin(GPIOA, GPIO_PIN_11, GPIO_PIN_RESET);
//	HAL_Delay(500);
//
//	// port 1 led 1
//	HAL_GPIO_WritePin(GPIOA, GPIO_PIN_12, GPIO_PIN_SET);
//	HAL_Delay(500);
//
//	HAL_GPIO_WritePin(GPIOA, GPIO_PIN_12, GPIO_PIN_RESET);
//	HAL_Delay(500);

    /* USER CODE END WHILE */

    /* USER CODE BEGIN 3 */
  }
  /* USER CODE END 3 */
}

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
