ExcessiveOverkill/hvsd-3ch/stm32/hvsd 3ch.ioc

Mcu.UserName=STM32G473QETx
PA0.Signal=S_TIM2_CH1
PA1.Signal=S_TIM2_CH2
PA10.Signal=USART1_RX
PA11.Signal=GPIO_Output
PA12.Signal=GPIO_Output
PA13.Signal=SYS_JTMS-SWDIO
PA14.Signal=SYS_JTCK-SWCLK
PA15.Signal=S_TIM8_CH1
PA2.Signal=ADC1_IN3
PA3.Signal=ADC1_IN4
PA4.Signal=S_TIM3_CH2
PA5.Signal=S_TIM2_ETR
PA6.Signal=ADC2_IN3
PA7.Signal=ADC2_IN4
PA8.Signal=OPAMP5_VOUT
PA9.Signal=USART1_TX
PB0.Signal=OPAMP2_VINP
PB1.Signal=ADC3_IN1
PB10.Signal=TIM1_BKIN
PB12.Signal=ADC4_IN3
PB13.Signal=ADC3_IN5
PB14.Signal=ADC1_IN5
PB15.Signal=ADC4_IN5
PB2.Signal=S_TIM5_CH1
PB3.Signal=SYS_JTDO-SWO
PB4.Signal=SPI3_MISO
PB5.Signal=TIM8_CH3N
PB6.Signal=TIM8_BKIN2
PB7.Signal=TIM8_BKIN
PB9.Signal=S_TIM8_CH3
PC1.Signal=ADC2_IN7
PC10.Signal=TIM8_CH1N
PC11.Signal=TIM8_CH2N
PC12.Signal=SPI3_MOSI
PC13.Signal=GPIO_Output
PC3.Signal=OPAMP5_VINP
PC4.Signal=ADC2_IN5
PC6.Signal=S_TIM3_CH1
PC7.Signal=S_TIM8_CH2
PC8.Signal=S_TIM20_CH3
PD0.Signal=FDCAN1_RX
PD1.Signal=FDCAN1_TX
PD10.Signal=ADC4_IN7
PD11.Signal=ADC3_IN8
PD12.Signal=ADC4_IN9
PD13.Signal=ADC4_IN10
PD14.Signal=ADC4_IN11
PD2.Signal=S_TIM3_ETR
PD4.Signal=GPIO_Output
PD5.Signal=USART2_TX
PD6.Signal=USART2_RX
PD8.Signal=USART3_TX
PD9.Signal=USART3_RX
PE0.Signal=S_TIM4_ETR
PE1.Signal=S_TIM17_CH1
PE10.Signal=TIM1_CH2N
PE11.Signal=S_TIM1_CH2
PE12.Signal=TIM1_CH3N
PE13.Signal=S_TIM1_CH3
PE14.Signal=TIM1_BKIN2
PE15.Signal=ADC4_IN2
PE2.Signal=S_TIM20_CH1
PE3.Signal=S_TIM20_CH2
PE4.Signal=GPIO_Output
PE5.Signal=GPIO_Output
PE6.Signal=GPIO_Output
PE7.Signal=ADC3_IN4
PE8.Signal=TIM1_CH1N
PE9.Signal=S_TIM1_CH1
PF0-OSC_IN.Signal=RCC_OSC_IN
PF11.Signal=GPIO_Input
PF12.Signal=GPIO_Input
PF13.Signal=GPIO_Input
PF3.Signal=I2C3_SCL
PF4.Signal=I2C3_SDA
PF6.Signal=GPIO_Output
PF9.Signal=S_TIM15_CH1
PG0.Signal=TIM20_CH1N
PG1.Signal=TIM20_CH2N
PG2.Signal=TIM20_CH3N
PG3.Signal=TIM20_BKIN
PG4.Signal=TIM20_BKIN2
PG5.Signal=GPIO_Output
PG6.Signal=GPIO_Output
PG9.Signal=SPI3_SCK
