ExcessiveOverkill/hvsd-3ch/(commit log)

2026-01-06 prepare rev0.1 for manufacturing
    [STO.kicad_sch, communication.kicad_sch, current_sense.kicad_sch, high voltage servo drive 3ch.kicad_pcb, high voltage servo drive 3ch.kicad_sch, inverter_A.kicad_sch, inverter_B.kicad_sch, inverter_C.kicad_sch]
2026-01-06 fix DRC issues
    [high voltage servo drive 3ch.kicad_pcb, power_connectors.kicad_sch]
2026-01-07 update BOM and change transceivers
    [STO.kicad_sch, communication.kicad_sch, current_sense.kicad_sch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]
2026-08-24 add rev 0.2 changes and rev 0.1 mfg files
    [BOM.csv, communication.kicad_sch, current_sense.kicad_sch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]
2026-08-24 update manufacturing files for rev 0.2
    [high voltage servo drive 3ch-B_Cu.gbr, high voltage servo drive 3ch-B_Mask.gbr, high voltage servo drive 3ch-B_Paste.gbr, high voltage servo drive 3ch-B_Silkscreen.gbr, high voltage servo drive 3ch-Edge_Cuts.gbr, high voltage servo drive 3ch-F_Cu.gbr, high voltage servo drive 3ch-F_Mask.gbr, high voltage servo drive 3ch-F_Paste.gbr]
2026-08-28 update bom
    [BOM.csv, communication.kicad_sch, current_sense.kicad_sch, microcontroller.kicad_sch, power_connectors.kicad_sch]
